NHK-DOT/delta_on_quadrotorUAV/docs/README.md

# 78arm Operational Documentation

This directory contains operational records maintained by the 78arm parent
repository. Documents here are not part of the nested upstream
`Uav_Delta_capture` Git repository.

## Available Documents

- [NX–STM32MP257 Wired LAN and ROS 2 Verification](NX_257_WIRED_LAN_AND_ROS2.md)
- [NX–STM32MP257 有线局域网与 ROS 2 通信验证](NX_257_WIRED_LAN_AND_ROS2.zh-CN.md)

The documents record verified device configuration and test results. They do
not grant flight authority or replace on-site safety checks.
