NHK-DOT/delta_on_quadrotorUAV/docs/README.zh-CN.md

# 78arm 运行文档

本目录保存由 78arm 父仓库维护的运行与验证记录，不属于嵌套的
`Uav_Delta_capture` 上游 Git 仓库。

## 文档列表

- [NX–STM32MP257 有线局域网与 ROS 2 通信验证](NX_257_WIRED_LAN_AND_ROS2.zh-CN.md)
- [NX–STM32MP257 Wired LAN and ROS 2 Verification](NX_257_WIRED_LAN_AND_ROS2.md)

文档记录已经验证的设备配置和测试结果，不构成飞行授权，也不能替代现场
安全检查。
