NHK-DOT/delta_on_quadrotorUAV/Uav_Delta_capture/docs/README.zh-CN.md

# 无人机集成文档

本文件是中文独立入口。报告保留“王迪论文报告”模板的排版、页面设置和表格结构，但内容改写为当前无人机抓取系统：STM32MP257 负责飞控任务主线，NX 负责视觉与机械臂，二者只通过受校验的观测与抓取状态接口协作。

文档不替代场地安全检查、飞控参数检查或人工飞行许可。
