NHK-DOT/delta_on_quadrotorUAV/THIRD_PARTY_NOTICES.md

# Third-Party Notices

## isaac879/Delta-Robot

Source: https://github.com/isaac879/Delta-Robot

License: MIT License

Upstream copyright:

```text
Copyright (c) 2019 isaac879 (Isaac Chasteau)
```

This repository's delta-arm mechanical concept and part of the early modeling
and control direction were based on the upstream Delta-Robot project. The model
files, hardware layout, control code, sensors, and deployment workflow in this
repository have been modified for this project's arm.

The overall 78arm repository is distributed under GNU GPL v3.0. The upstream MIT
notice below is preserved for MIT-origin material and attribution.

## MIT License Text

```text
MIT License

Copyright (c) 2019 isaac879 (Isaac Chasteau)

Permission is hereby granted, free of charge, to any person obtaining a copy
of this software and associated documentation files (the "Software"), to deal
in the Software without restriction, including without limitation the rights
to use, copy, modify, merge, publish, distribute, sublicense, and/or sell
copies of the Software, and to permit persons to whom the Software is
furnished to do so, subject to the following conditions:

The above copyright notice and this permission notice shall be included in all
copies or substantial portions of the Software.

THE SOFTWARE IS PROVIDED "AS IS", WITHOUT WARRANTY OF ANY KIND, EXPRESS OR
IMPLIED, INCLUDING BUT NOT LIMITED TO THE WARRANTIES OF MERCHANTABILITY,
FITNESS FOR A PARTICULAR PURPOSE AND NONINFRINGEMENT. IN NO EVENT SHALL THE
AUTHORS OR COPYRIGHT HOLDERS BE LIABLE FOR ANY CLAIM, DAMAGES OR OTHER
LIABILITY, WHETHER IN AN ACTION OF CONTRACT, TORT OR OTHERWISE, ARISING FROM,
OUT OF OR IN CONNECTION WITH THE SOFTWARE OR THE USE OR OTHER DEALINGS IN THE
SOFTWARE.
```
