NHK-DOT/delta_on_quadrotorUAV/Uav_Delta_capture/UPSTREAM_SOURCE.md

# Upstream Source / 上游来源

## English

This directory is an imported integration copy of the UAV ROS 2 project. It originates from `https://github.com/Nocoding0/Uav_Delta_capture.git` at commit `1c27e88051174780e2267d8d063ff80affeebd91` (`after the first competition`, fetched July 13, 2026).

It is intentionally maintained inside the 78arm repository so the NX vision-and-arm integration can evolve without pushing changes to the upstream repository. Do not add the upstream `.git` directory here. Upstream flight-control, UWB, and STM32MP257 code remains attributable to the source project.

## 中文

本目录是无人机 ROS 2 项目的导入集成副本，来源为 `https://github.com/Nocoding0/Uav_Delta_capture.git`，固定提交为 `1c27e88051174780e2267d8d063ff80affeebd91`（`after the first competition`，获取日期为 2026-07-13）。

本副本刻意维护在 78arm 仓库内，使 NX 的视觉与机械臂集成可以演进，同时不向上游仓库推送修改。此处不得放入上游 `.git` 目录。飞控、UWB 和 STM32MP257 代码仍应明确归属原项目。
