NHK-DOT/delta_on_quadrotorUAV/最新ALX-AOA-FIT跟随套件开发资料/示例代码/例程说明.txt

STM32F1-Usart    压缩包是STM32单片机串口获取基站数据的代码例程。
