NHK-DOT/delta_on_quadrotorUAV/最新ALX-AOA-FIT跟随套件开发资料/单基站&双基站&四基站/基站转接板安装孔位.pdf

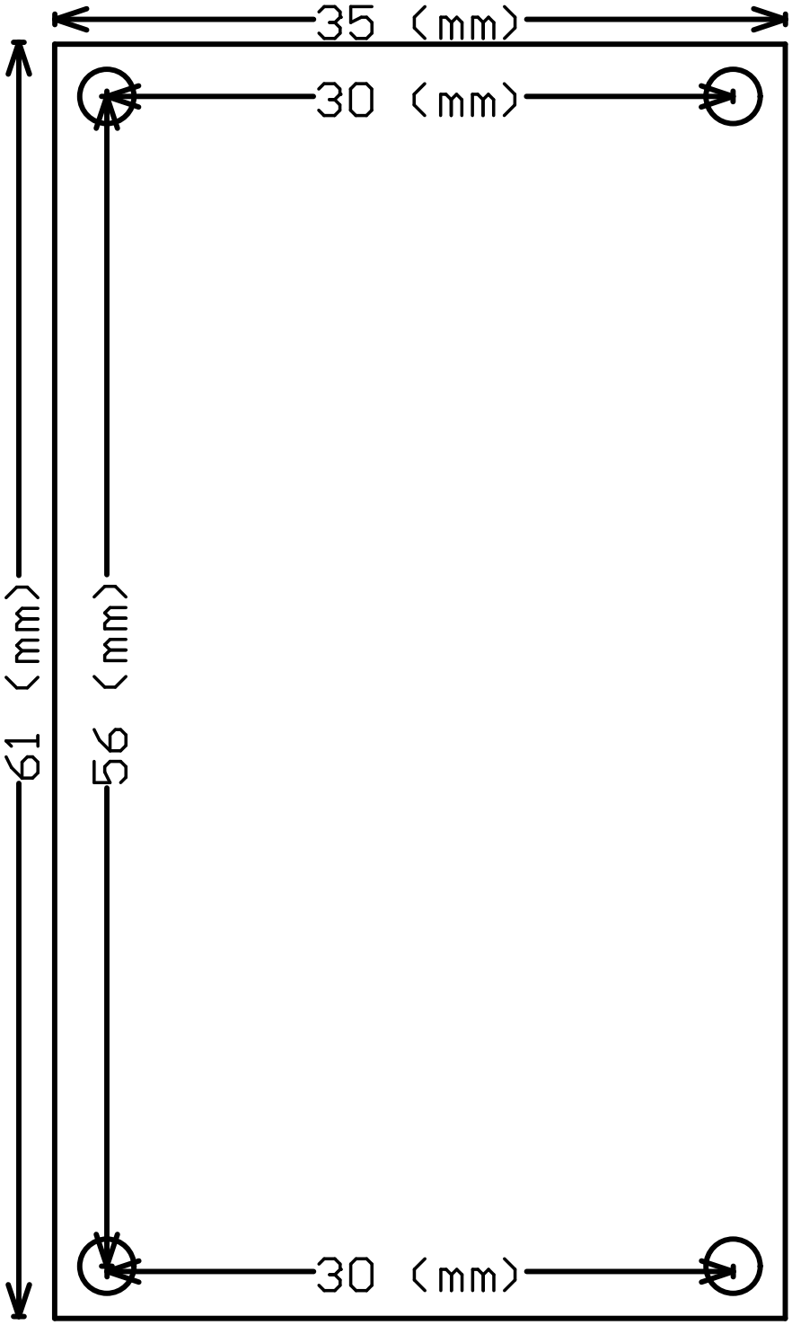
[picture p36: figure]
