NHK-DOT/delta_on_quadrotorUAV/Uav_Delta_capture/archive_legacy/20260413.md

# 2026-04-13 工作记录

## 今日目标
- 推进“模拟飞控 + 真实飞控基础链路”从骨架到可联调状态。
- 优先打通“桥接 -> failsafe -> 运动学”执行闭环。

## 今日主要改动

### 1) 运动学输入可切换（接入 failsafe 输出）
- 为 `delta_kinematics_node` 增加参数 `target_topic`。
- 支持将运动学输入从 `target_point` 切换为 `target_point_safe`。

涉及文件：
- src/delta_kinematics/include/delta_kinematics/delta_kinematics.hpp
- src/delta_kinematics/src/delta_kinematics_node.cpp
- src/delta_kinematics/config/delta_kinematics.yaml

### 2) FCU 链路健康监控增强
- 在 `fcu_link_monitor_node` 增加去抖参数：
  - `lost_threshold_count`
  - `ok_threshold_count`
- 避免短时抖动导致状态频繁误切换。

涉及文件：
- src/uav_bridge/src/fcu_link_monitor_node.cpp
- src/uav_bridge/config/fcu_health.yaml

### 3) failsafe 输出机制增强
- 在 `failsafe_manager_node` 增加：
  - `input_timeout_sec`（输入新鲜度判断）
  - `output_rate_hz`（周期输出）
- 实现“链路异常时持续输出安全点”。

涉及文件：
- src/uav_bridge/src/failsafe_manager_node.cpp
- src/uav_bridge/config/failsafe.yaml

### 4) 启动编排统一
- 重构统一启动：`uav_delta_system.launch.py`，支持：
  - `use_mock_fcu`
  - `start_mavros`
  - `start_fcu_guard`
  - `delta_target_topic`
- `uav_delta_with_mock_fcu.launch.py` 与 `uav_delta_with_fcu.launch.py` 改为复用统一系统启动。

涉及文件：
- src/uav_bridge/launch/uav_delta_system.launch.py
- src/uav_bridge/launch/uav_delta_with_mock_fcu.launch.py
- src/uav_bridge/launch/uav_delta_with_fcu.launch.py

### 5) 依赖与文档同步
- MAVROS 参数模板兼容性调整（`/**:` 作用域）。
- `package.xml` 增加运行依赖 `mavros`。
- README 更新路径与统一启动示例。

涉及文件：
- src/uav_bridge/config/mavros_bridge.yaml
- src/uav_bridge/package.xml
- uav_delta_capture/README.md

## 今日遇到的报错/异常

1. 终端会话中断
- 现象：执行串联验证命令时出现终端被关闭、命令退出 `130`。
- 原因：多段命令中含中断/超时流程，导致会话被提前终止。
- 处理：改为分步执行；出现残留进程时用 `pkill` 清理。

2. 话题采样时短暂告警
- 现象：`ros2 topic hz /mavros/local_position/pose` 提示 `topic does not appear to be published yet`。
- 原因：采样开始早于系统稳定拉起时刻。
- 处理：增加启动等待时间并通过 launch 日志确认节点已运行。

3. `KeyboardInterrupt`（Perception 节点）
- 现象：手动 `Ctrl-C` 结束联调时，Python 节点抛出中断栈。
- 结论：正常退出路径，不是功能性缺陷。

4. `get_changed_files` 提示非 git 仓库
- 现象：工具返回当前目录不是 git 仓库。
- 处理：改用直接文件核对与构建验证，不影响本次实现。

## 今日问题解决清单
- 解决了 failsafe 输出未进入运动学执行链的问题。
- 解决了健康状态抖动易误触发的问题（增加门限去抖）。
- 解决了启动文件重复维护的问题（统一系统启动入口）。
- 解决了 mock/真实 FCU 切换成本高的问题（参数化切换）。

## 今日达成成果
- 已形成可联调最小闭环：
  - Mock FCU -> `/mavros/local_position/pose`
  - `fcu_link_monitor_node` -> `fcu_link/status`
  - `failsafe_manager_node` -> `target_point_safe`
  - `delta_kinematics_node` 消费安全目标并输出 `joint_angles`
- 构建验证通过：
  - `colcon build --symlink-install --packages-select uav_bridge delta_kinematics`
- 启动参数检查通过：
  - 系统启动、mock 启动、FCU 启动均可展示参数列表。

## 下一步建议
1. 为 `flight_state_machine_node` 增加恢复保持窗口、故障锁存与更明确迁移条件。
2. 增加诊断输出（故障码、最近心跳时间、触发计数）。
3. 增加最小控制面骨架（arming/mode service client），先做接口不下发危险动作。
4. 固化 TF/坐标系约定并写入联调规范，避免后续返工。
