NHK-DOT/delta_on_quadrotorUAV/AprilTag_Vision/myAprilTag/image/tag36h11_id_08_80mm.png

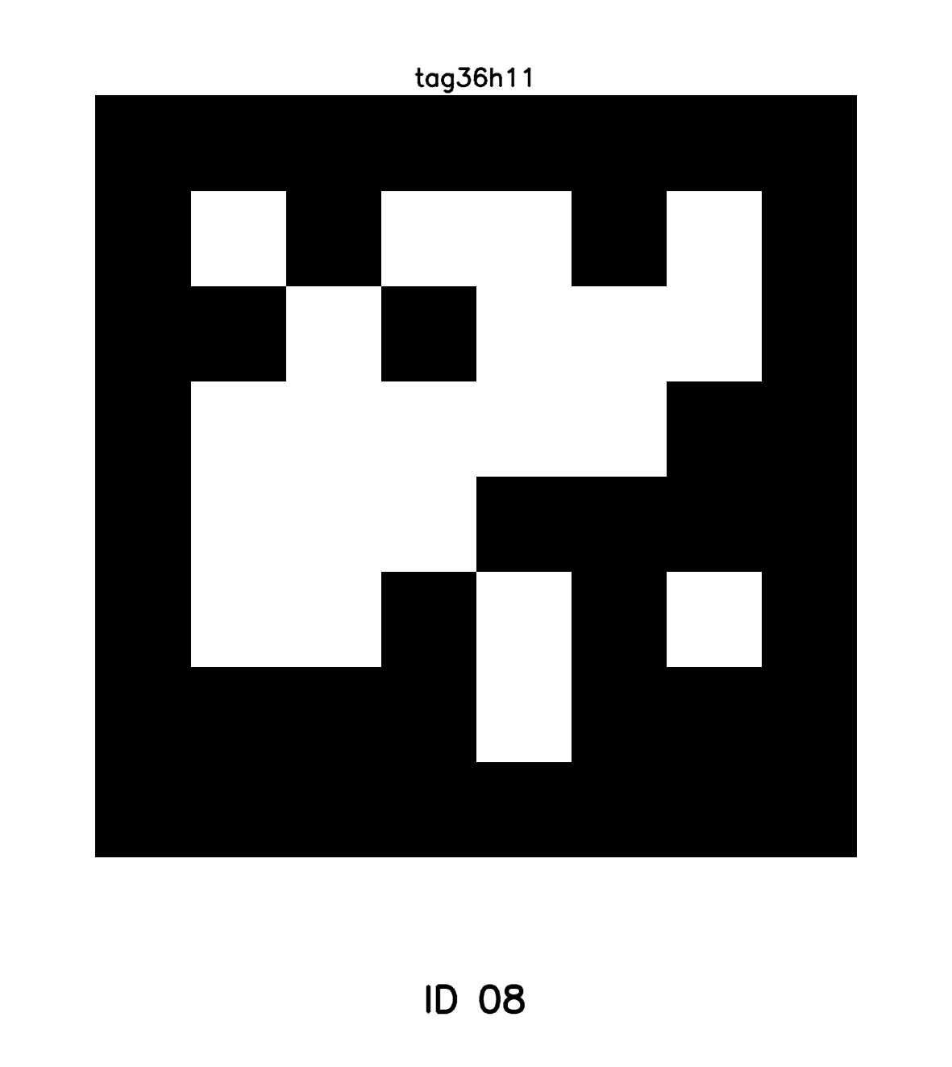
AprilTag_Vision/myAprilTag/image/tag36h11_id_08_80mm.png
