NHK-DOT/delta_on_quadrotorUAV/AprilTag_Vision/myAprilTag/image/tag36h11_sheet_page_02_80mm_A4.png

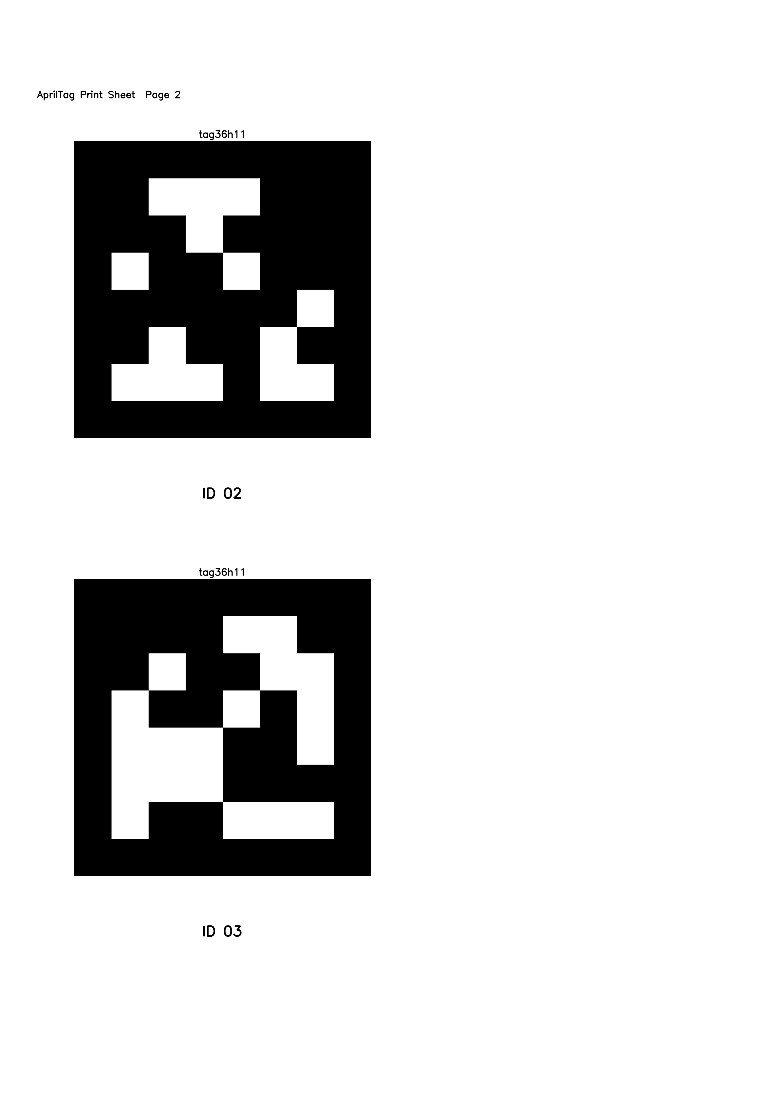
AprilTag_Vision/myAprilTag/image/tag36h11_sheet_page_02_80mm_A4.png
