NHK-DOT/delta_on_quadrotorUAV/Dual_Camera_HandEye/yolo_training/datasets/wrench_autolabel_20260626/images/train/wrench_static_1782480276551_00001.jpg

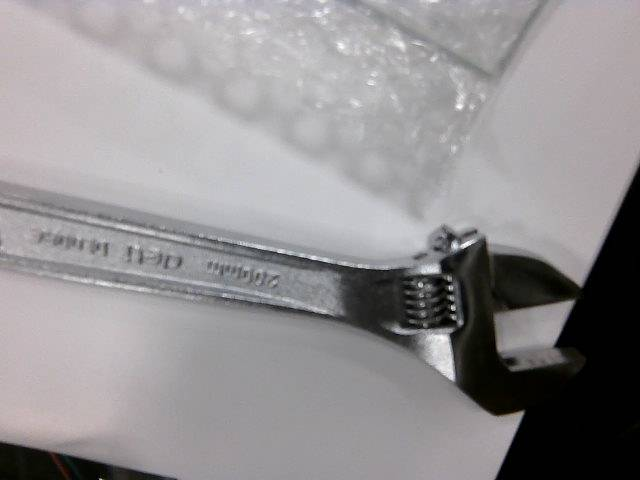
Dual_Camera_HandEye/yolo_training/datasets/wrench_autolabel_20260626/images/train/wrench_static_1782480276551_00001.jpg
