NHK-DOT/delta_on_quadrotorUAV/Dual_Camera_HandEye/yolo_training/datasets/wrench_autolabel_20260626_flight_aug/images/val/wrench_static_val_1782480300179_00001_flightaug_01.jpg

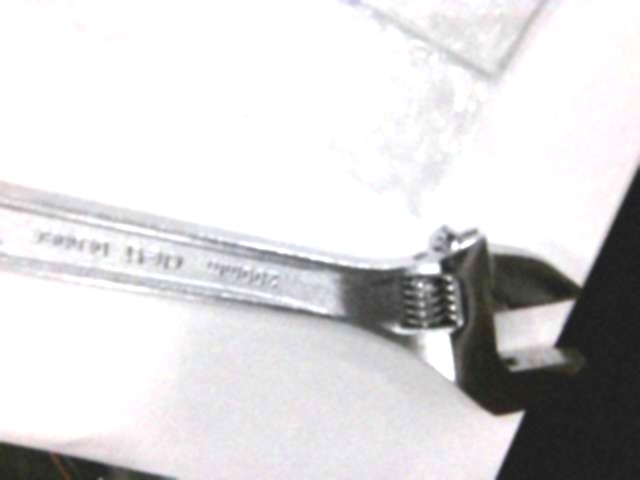
Dual_Camera_HandEye/yolo_training/datasets/wrench_autolabel_20260626_flight_aug/images/val/wrench_static_val_1782480300179_00001_flightaug_01.jpg
