NHK-DOT/delta_on_quadrotorUAV/Dual_Camera_HandEye/yolo_training/datasets/wrench_autolabel_20260626_qc_contact_sheet.jpg

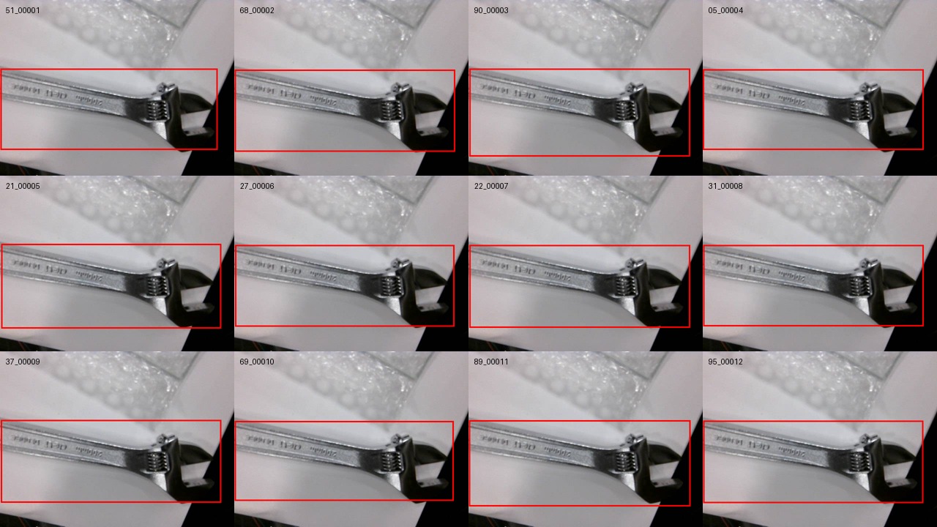
Dual_Camera_HandEye/yolo_training/datasets/wrench_autolabel_20260626_qc_contact_sheet.jpg
