NHK-DOT/delta_on_quadrotorUAV/Dual_Camera_HandEye/yolo_training/datasets/wrench_motion_autolabel_20260626_214357/images/train/motion_p00_f00_1782481438606.jpg

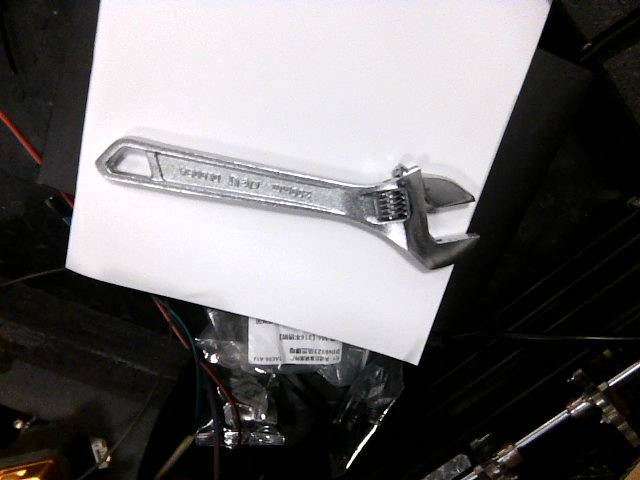
Dual_Camera_HandEye/yolo_training/datasets/wrench_motion_autolabel_20260626_214357/images/train/motion_p00_f00_1782481438606.jpg
