NHK-DOT/delta_on_quadrotorUAV/Dual_Camera_HandEye/yolo_training/datasets/wrench_motion_autolabel_20260626_214357/images/train/motion_p01_f01_1782481439942.jpg

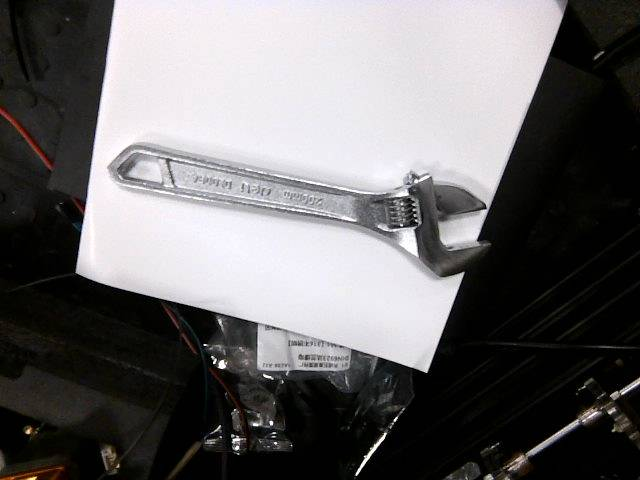
Dual_Camera_HandEye/yolo_training/datasets/wrench_motion_autolabel_20260626_214357/images/train/motion_p01_f01_1782481439942.jpg
