NHK-DOT/delta_on_quadrotorUAV/images/airframe/22-18 250mm碳纤维管机臂.jpg

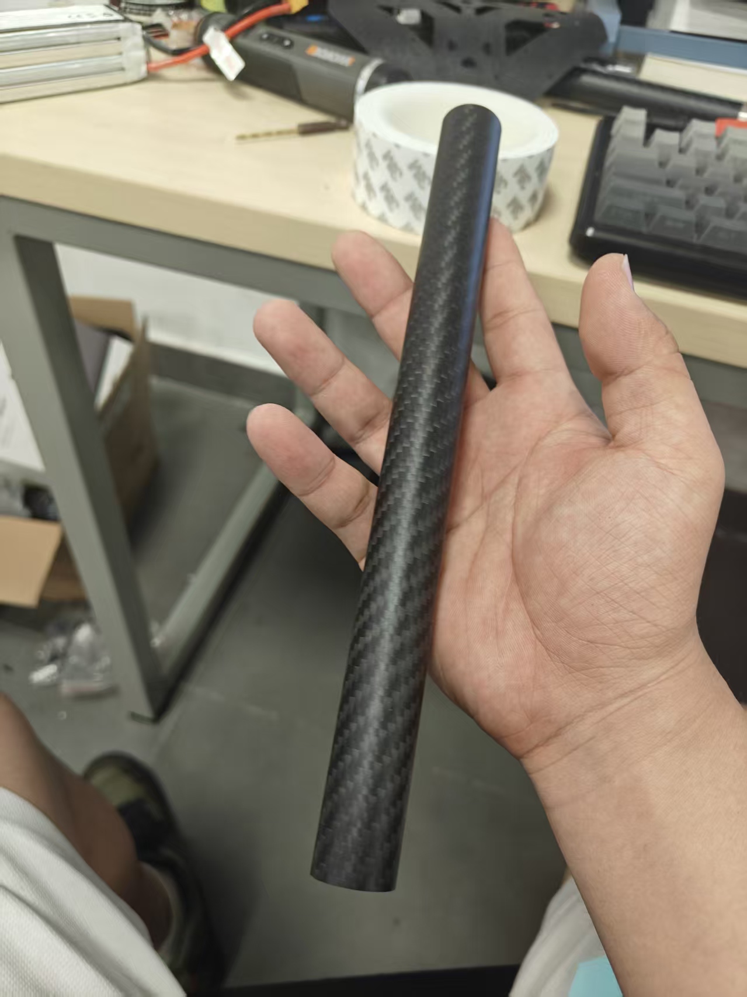
images/airframe/22-18 250mm碳纤维管机臂.jpg
