NHK-DOT/delta_on_quadrotorUAV/images/airframe/单根机臂一览.jpg

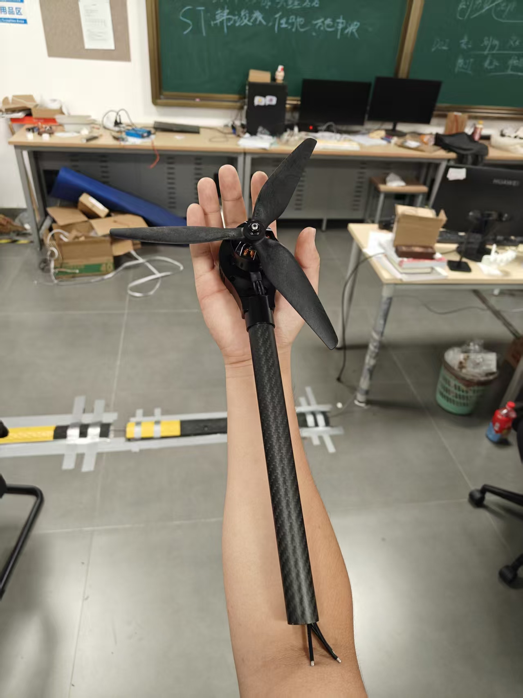
images/airframe/单根机臂一览.jpg
