NHK-DOT/delta_on_quadrotorUAV/images/airframe/大肌佬.jpg

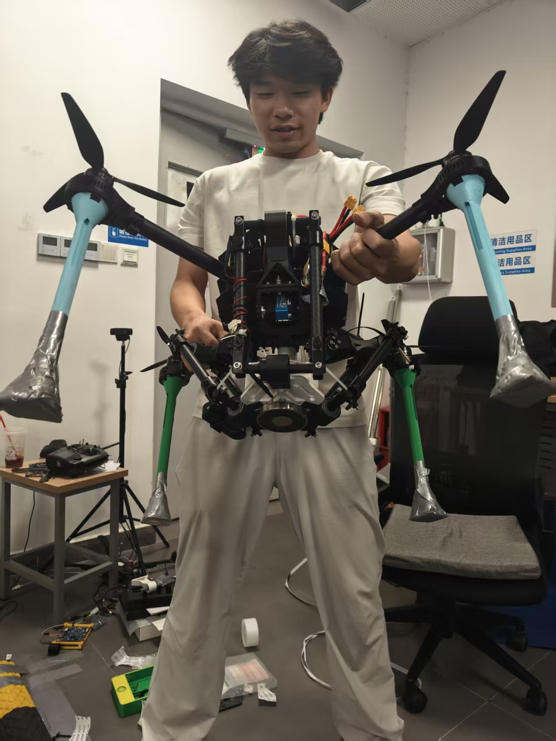
images/airframe/大肌佬.jpg
