NHK-DOT/delta_on_quadrotorUAV/images/airframe/定妆照.jpg

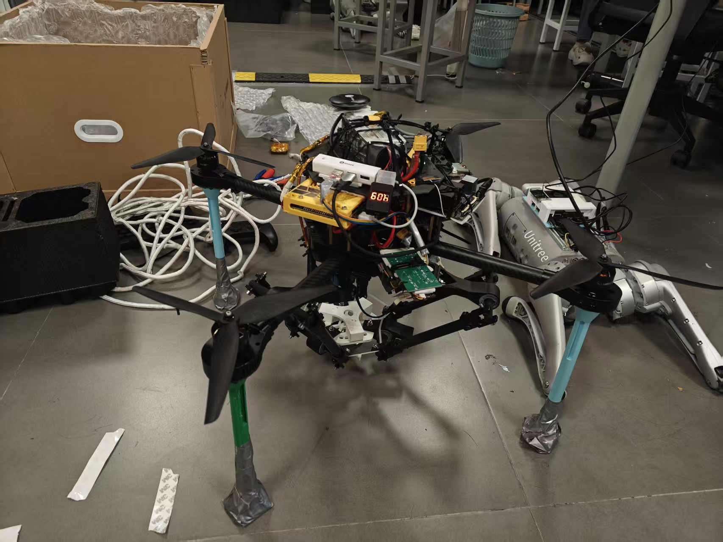
images/airframe/定妆照.jpg
