NHK-DOT/delta_on_quadrotorUAV/images/arm/3d对应一览.jpg

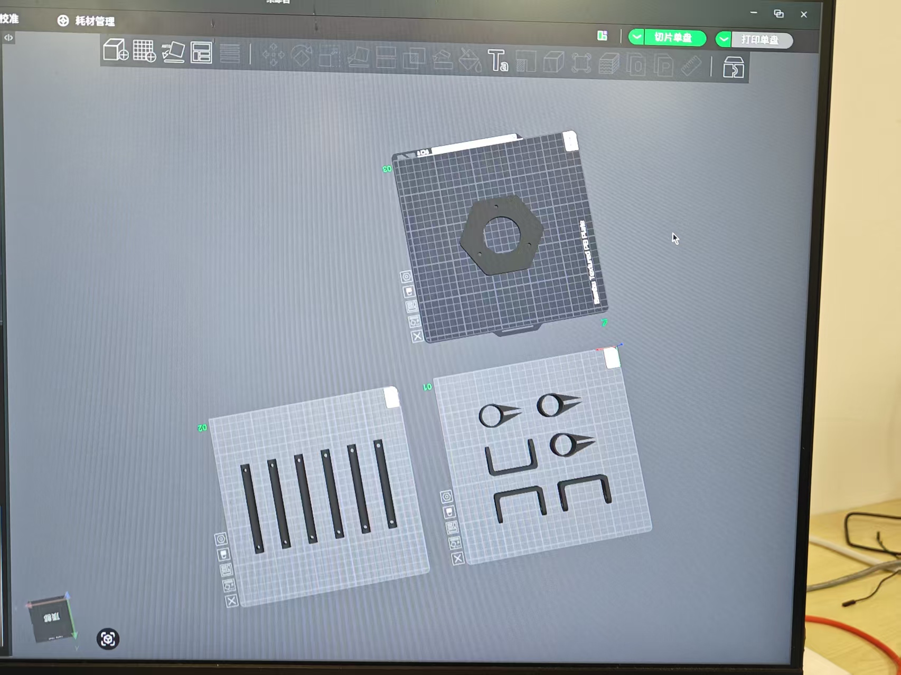
images/arm/3d对应一览.jpg
