NHK-DOT/delta_on_quadrotorUAV/images/arm/RGBD相机.jpg

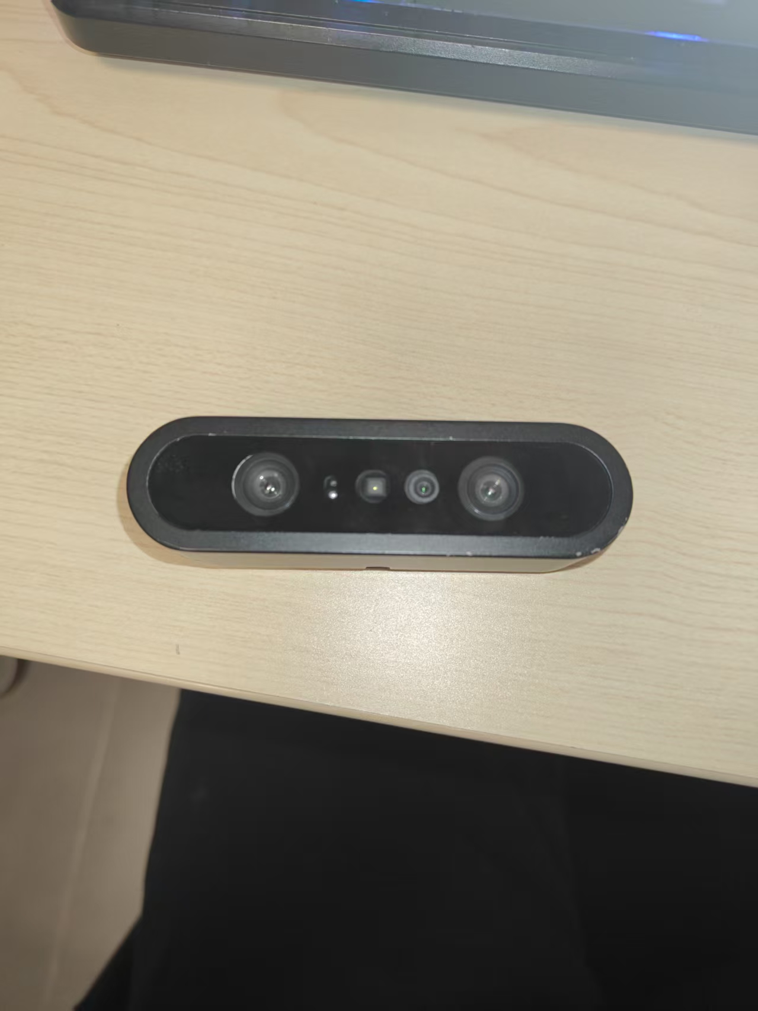
images/arm/RGBD相机.jpg
