NHK-DOT/delta_on_quadrotorUAV/images/arm/下小臂.jpg

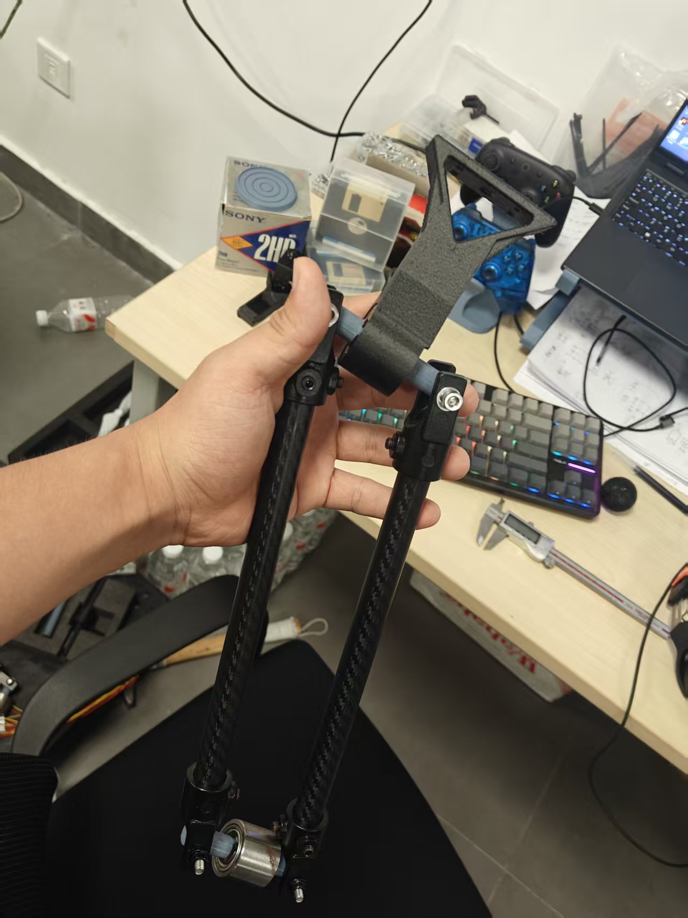
images/arm/下小臂.jpg
