NHK-DOT/delta_on_quadrotorUAV/images/arm/大（上）臂.jpg

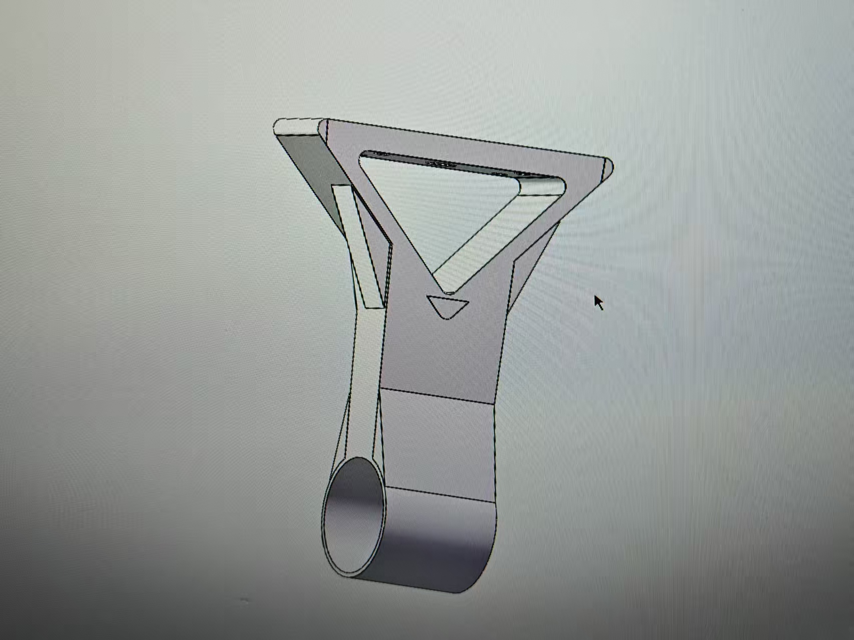
images/arm/大（上）臂.jpg
