NHK-DOT/delta_on_quadrotorUAV/images/arm/快拆末端中心板.png

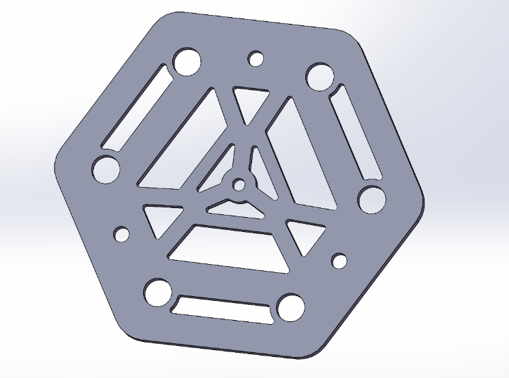
images/arm/快拆末端中心板.png
