NHK-DOT/delta_on_quadrotorUAV/images/arm/末端一览.jpg

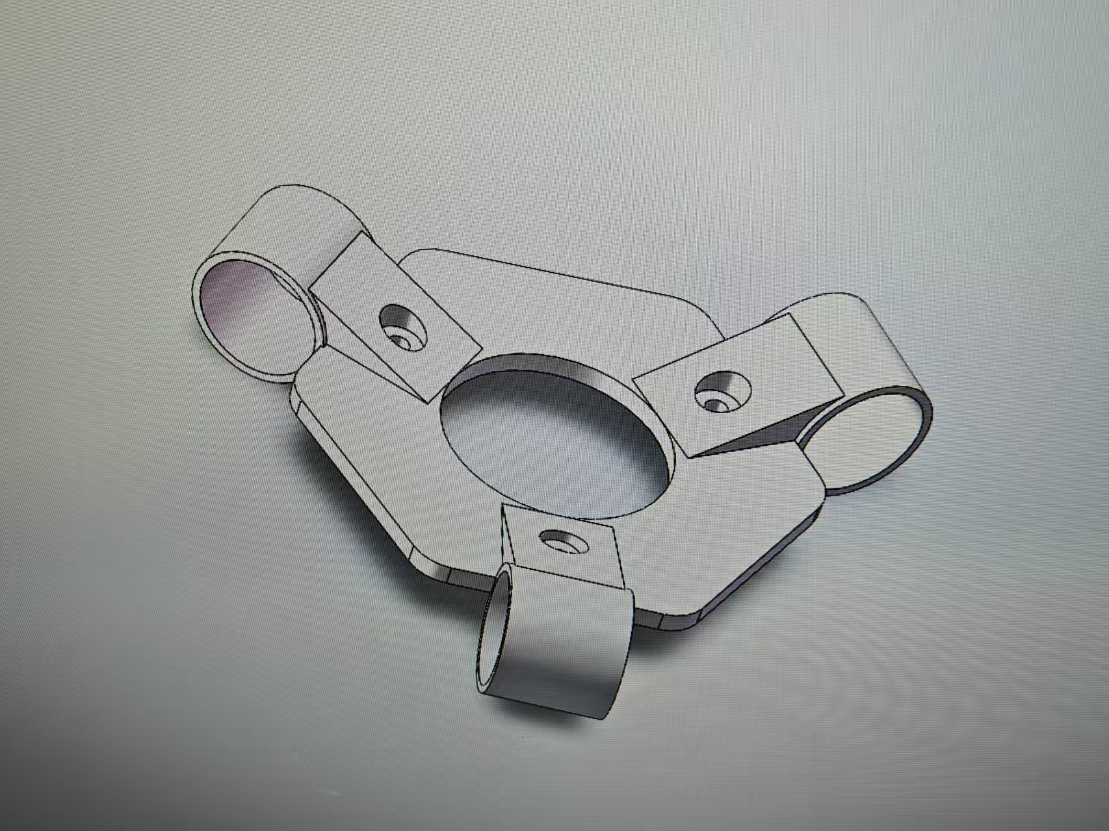
images/arm/末端一览.jpg
