NHK-DOT/delta_on_quadrotorUAV/images/arm/机械臂底盘.png

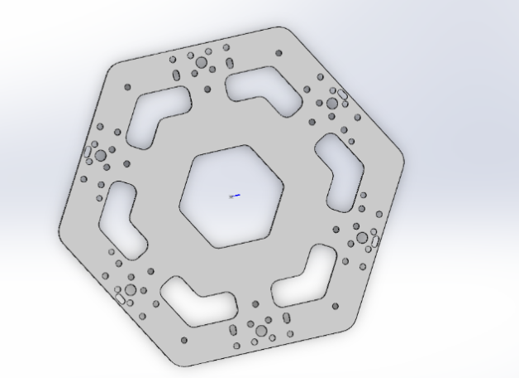
images/arm/机械臂底盘.png
