NHK-DOT/delta_on_quadrotorUAV/images/arm/轴承套筒6001.png

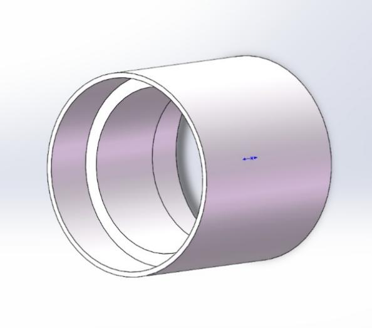
images/arm/轴承套筒6001.png
