NHK-DOT/delta_on_quadrotorUAV/images/electronics/773f6542a918e4f045dfaee116f9853e.png

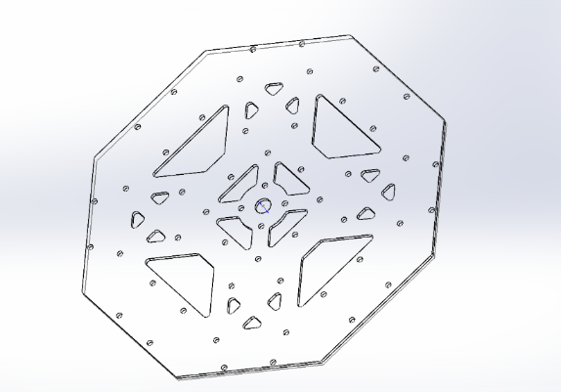
images/electronics/773f6542a918e4f045dfaee116f9853e.png
