NHK-DOT/delta_on_quadrotorUAV/images/electronics/分电成品.png

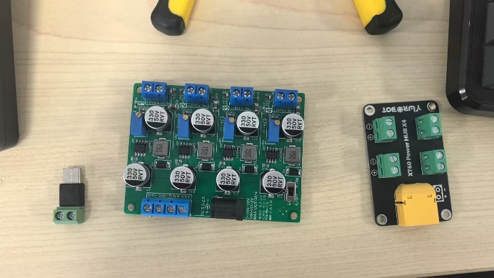
images/electronics/分电成品.png
