NHK-DOT/delta_on_quadrotorUAV/images/electronics/手绘分电.png

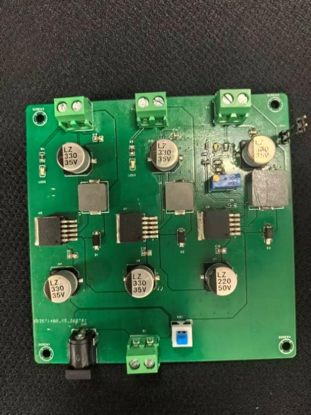
images/electronics/手绘分电.png
