NHK-DOT/delta_on_quadrotorUAV/images/electronics/电调好盈科技XRotor_65A_4in1_6S_Lite_BLS_RTF.png

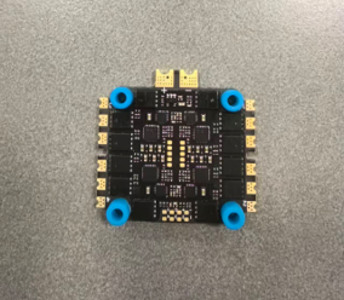
images/electronics/电调好盈科技XRotor_65A_4in1_6S_Lite_BLS_RTF.png
