NHK-DOT/delta_on_quadrotorUAV/tool_vision_web/jetson_raw_probe.jpg

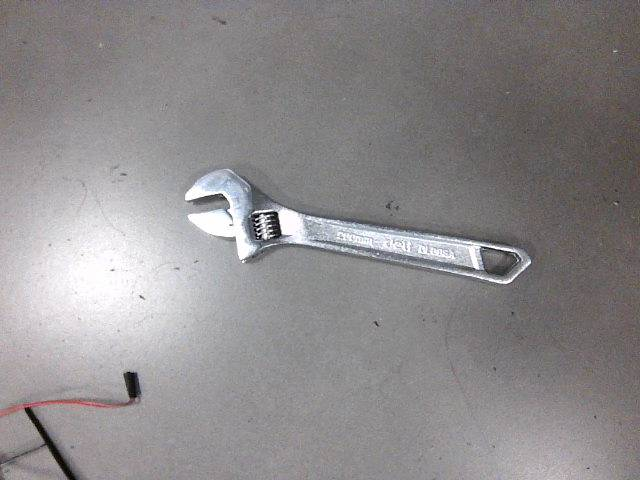
tool_vision_web/jetson_raw_probe.jpg
