NHK-DOT/delta_on_quadrotorUAV/(list of files, cad)

Other CAD files:
drawings/desktop_cad_import_20260714/【RM2024-空中机器人结构开源】-深圳大学-RobotPilots战队/三维模型/云台/相机/装配体-视觉相机镜头.SLDASM
drawings/desktop_cad_import_20260714/【RM2024-空中机器人结构开源】-深圳大学-RobotPilots战队/三维模型/机架上层/飞控安装板/装配体-飞控安装板.SLDASM
drawings/desktop_cad_import_20260714/【RM2024-空中机器人结构开源】-深圳大学-RobotPilots战队/三维模型/机臂动力套装/装配体-机臂动力套装-圆管-反.SLDASM
drawings/desktop_cad_import_20260714/【RM2024-空中机器人结构开源】-深圳大学-RobotPilots战队/三维模型/机架上层/电池架/M600配件/官方元件-M600电池架.SLDASM
drawings/desktop_cad_import_20260714/【RM2024-空中机器人结构开源】-深圳大学-RobotPilots战队/三维模型/机架上层/电池架/装配体-电池架及电池.SLDASM
drawings/desktop_cad_import_20260714/【RM2024-空中机器人结构开源】-深圳大学-RobotPilots战队/三维模型/机架上层/飞控安装板/标准件-DJI - A3 - LED Module.SLDASM
drawings/desktop_cad_import_20260714/【RM2024-空中机器人结构开源】-深圳大学-RobotPilots战队/三维模型/机臂动力套装/螺旋桨/装配体-2892反桨.SLDASM
drawings/desktop_cad_import_20260714/【RM2024-空中机器人结构开源】-深圳大学-RobotPilots战队/三维模型/机臂动力套装/装配体-机臂动力套装-圆管.SLDASM
drawings/desktop_cad_import_20260714/【RM2024-空中机器人结构开源】-深圳大学-RobotPilots战队/三维模型/云台/NUC12/装配体-NUC12保护装配.SLDASM
drawings/desktop_cad_import_20260714/【RM2024-空中机器人结构开源】-深圳大学-RobotPilots战队/三维模型/云台/设备/标准件-主控板装配.SLDASM
drawings/desktop_cad_import_20260714/【RM2024-空中机器人结构开源】-深圳大学-RobotPilots战队/三维模型/机架上层/飞猫连接架/装配体-飞猫连接架.SLDASM
drawings/desktop_cad_import_20260714/【RM2024-空中机器人结构开源】-深圳大学-RobotPilots战队/三维模型/机臂动力套装/螺旋桨/装配体-2892正桨.SLDASM
drawings/desktop_cad_import_20260714/【RM2024-空中机器人结构开源】-深圳大学-RobotPilots战队/三维模型/云台/装配体-云台设备仓.SLDASM
drawings/desktop_cad_import_20260714/【RM2024-空中机器人结构开源】-深圳大学-RobotPilots战队/三维模型/机架上层/拨盘总装（2_10）/装配体-拨盘.SLDASM
drawings/desktop_cad_import_20260714/【RM2024-空中机器人结构开源】-深圳大学-RobotPilots战队/三维模型/机架上层/装配体-机架上层.SLDASM
drawings/desktop_cad_import_20260714/【RM2024-空中机器人结构开源】-深圳大学-RobotPilots战队/三维模型/机架上层/起落架/装配-起落架.SLDASM
drawings/desktop_cad_import_20260714/【RM2024-空中机器人结构开源】-深圳大学-RobotPilots战队/三维模型/云台/摩擦轮电机/标准件-朗宇2212-KV980.SLDASM
drawings/desktop_cad_import_20260714/【RM2024-空中机器人结构开源】-深圳大学-RobotPilots战队/三维模型/机臂动力套装/桨保/装配-桨保.SLDASM
drawings/desktop_cad_import_20260714/【RM2024-空中机器人结构开源】-深圳大学-RobotPilots战队/三维模型/机架上层/标准件-DJI - A3 - GPS-Compass PRO.SLDASM
drawings/desktop_cad_import_20260714/【RM2024-空中机器人结构开源】-深圳大学-RobotPilots战队/三维模型/机架上层/UWB支架/UWB碳板支架装配.SLDASM
drawings/desktop_cad_import_20260714/【RM2024-空中机器人结构开源】-深圳大学-RobotPilots战队/三维模型/云台/装配体-云台Pitch装配.SLDASM
part_model_rev/1.SLDASM
part_model_rev/对孔.SLDASM
part_model_rev/配合.SLDASM
drawings/desktop_cad_import_20260714/【RM2024-空中机器人结构开源】-深圳大学-RobotPilots战队/三维模型/云台/装配体-云台.SLDASM
drawings/desktop_cad_import_20260714/【RM2024-空中机器人结构开源】-深圳大学-RobotPilots战队/三维模型/云台/NUC12/NUC12简化.SLDPRT
drawings/desktop_cad_import_20260714/【RM2024-空中机器人结构开源】-深圳大学-RobotPilots战队/三维模型/云台/摩擦轮电机/eje.SLDPRT
drawings/desktop_cad_import_20260714/【RM2024-空中机器人结构开源】-深圳大学-RobotPilots战队/三维模型/云台/板材-7010电机侧板 -国赛.SLDPRT
drawings/desktop_cad_import_20260714/【RM2024-空中机器人结构开源】-深圳大学-RobotPilots战队/三维模型/云台/设备/标准件-XT30ULW-F.SLDPRT
drawings/desktop_cad_import_20260714/【RM2024-空中机器人结构开源】-深圳大学-RobotPilots战队/三维模型/小推车/打印件-小推车90度转接.SLDPRT
drawings/desktop_cad_import_20260714/【RM2024-空中机器人结构开源】-深圳大学-RobotPilots战队/三维模型/机架上层/UWB支架/标准件-M3x16铝柱.SLDPRT
drawings/desktop_cad_import_20260714/【RM2024-空中机器人结构开源】-深圳大学-RobotPilots战队/三维模型/机架上层/拨盘总装（2_10）/打印件-拨盘外壁v1.3.SLDPRT
drawings/desktop_cad_import_20260714/【RM2024-空中机器人结构开源】-深圳大学-RobotPilots战队/三维模型/机架上层/标准件-gps安装座.SLDPRT
drawings/desktop_cad_import_20260714/【RM2024-空中机器人结构开源】-深圳大学-RobotPilots战队/三维模型/机架上层/电池架/M600配件/官方元件-电池架铜片.SLDPRT
drawings/desktop_cad_import_20260714/【RM2024-空中机器人结构开源】-深圳大学-RobotPilots战队/三维模型/机架上层/电池架/打印件-电池架固定座.SLDPRT
drawings/desktop_cad_import_20260714/【RM2024-空中机器人结构开源】-深圳大学-RobotPilots战队/三维模型/机架上层/起落架/板材-起落架加强板.SLDPRT
drawings/desktop_cad_import_20260714/【RM2024-空中机器人结构开源】-深圳大学-RobotPilots战队/三维模型/机架上层/飞猫连接架/标准件-16mm管夹.SLDPRT
drawings/desktop_cad_import_20260714/【RM2024-空中机器人结构开源】-深圳大学-RobotPilots战队/三维模型/机臂动力套装/桨保/打印件-桨保机臂中段连接.SLDPRT
drawings/desktop_cad_import_20260714/【RM2024-空中机器人结构开源】-深圳大学-RobotPilots战队/三维模型/机臂动力套装/航行灯/打印件-顶部灯条.SLDPRT
drawings/desktop_cad_import_20260714/【RM2024-空中机器人结构开源】-深圳大学-RobotPilots战队/三维模型/机臂动力套装/螺旋桨/标准件-2892螺旋桨-反.SLDPRT
drawings/desktop_cad_import_20260714/【RM2024-空中机器人结构开源】-深圳大学-RobotPilots战队/三维模型/装配体-RoboMaster2024深圳大学空中机器人.STEP
drawings/desktop_cad_import_20260714/肱二头肌.STL
part_model_rev/保存实体1[2].SLDPRT
drawings/desktop_cad_import_20260714/78.STL
drawings/desktop_cad_import_20260714/【RM2024-空中机器人结构开源】-深圳大学-RobotPilots战队/三维模型/云台/NUC12/NUC12WSB保护.SLDPRT
drawings/desktop_cad_import_20260714/【RM2024-空中机器人结构开源】-深圳大学-RobotPilots战队/三维模型/云台/摩擦轮电机/angular contact ball bearing_68_iso.sldprt
drawings/desktop_cad_import_20260714/【RM2024-空中机器人结构开源】-深圳大学-RobotPilots战队/三维模型/云台/板材-云台pitch载板.SLDPRT
drawings/desktop_cad_import_20260714/【RM2024-空中机器人结构开源】-深圳大学-RobotPilots战队/三维模型/云台/相机/标准件-镜头.SLDPRT
drawings/desktop_cad_import_20260714/【RM2024-空中机器人结构开源】-深圳大学-RobotPilots战队/三维模型/云台/设备/标准件-DR16.SLDPRT
drawings/desktop_cad_import_20260714/【RM2024-空中机器人结构开源】-深圳大学-RobotPilots战队/三维模型/小推车/打印件-小推车90度方管.SLDPRT
drawings/desktop_cad_import_20260714/【RM2024-空中机器人结构开源】-深圳大学-RobotPilots战队/三维模型/机架上层/UWB支架/UWB连接.SLDPRT
drawings/desktop_cad_import_20260714/【RM2024-空中机器人结构开源】-深圳大学-RobotPilots战队/三维模型/机架上层/拨盘总装（2_10）/打印件-拨盘90度弹链.SLDPRT
drawings/desktop_cad_import_20260714/【RM2024-空中机器人结构开源】-深圳大学-RobotPilots战队/三维模型/机架上层/板材-上层下板.SLDPRT
drawings/desktop_cad_import_20260714/【RM2024-空中机器人结构开源】-深圳大学-RobotPilots战队/三维模型/机架上层/起落架/标准件-Foot_Pad.SLDPRT
drawings/desktop_cad_import_20260714/【RM2024-空中机器人结构开源】-深圳大学-RobotPilots战队/三维模型/机架上层/飞猫连接架/板材-吊杆连接板.SLDPRT
drawings/desktop_cad_import_20260714/【RM2024-空中机器人结构开源】-深圳大学-RobotPilots战队/三维模型/机臂动力套装/桨保/标准件-M3x20铝柱.SLDPRT
part_model_rev/韩竣成 (1).3mf
drawings/desktop_cad_import_20260714/ajydgsaiuu.3mf
drawings/desktop_cad_import_20260714/【RM2024-空中机器人结构开源】-深圳大学-RobotPilots战队/三维模型/云台/NUC12/NUC12保护顶盖.SLDPRT
drawings/desktop_cad_import_20260714/【RM2024-空中机器人结构开源】-深圳大学-RobotPilots战队/三维模型/云台/摩擦轮电机/Base motor.SLDPRT
drawings/desktop_cad_import_20260714/【RM2024-空中机器人结构开源】-深圳大学-RobotPilots战队/三维模型/云台/标准件-图传M2x20铝柱.SLDPRT
drawings/desktop_cad_import_20260714/【RM2024-空中机器人结构开源】-深圳大学-RobotPilots战队/三维模型/云台/相机/标准件-HKVision.SLDPRT
drawings/desktop_cad_import_20260714/【RM2024-空中机器人结构开源】-深圳大学-RobotPilots战队/三维模型/云台/设备/标准件-XL4015降压模块.SLDPRT
drawings/desktop_cad_import_20260714/【RM2024-空中机器人结构开源】-深圳大学-RobotPilots战队/三维模型/机架上层/UWB支架/UWB顶板.SLDPRT
drawings/desktop_cad_import_20260714/【RM2024-空中机器人结构开源】-深圳大学-RobotPilots战队/三维模型/机架上层/板材-Guidance安装板.SLDPRT
drawings/desktop_cad_import_20260714/【RM2024-空中机器人结构开源】-深圳大学-RobotPilots战队/三维模型/机架上层/电池架/标准件-TB48S.SLDPRT
drawings/desktop_cad_import_20260714/【RM2024-空中机器人结构开源】-深圳大学-RobotPilots战队/三维模型/机架上层/起落架/加工件-起落架碳管下-600mm.SLDPRT
drawings/desktop_cad_import_20260714/【RM2024-空中机器人结构开源】-深圳大学-RobotPilots战队/三维模型/机架上层/飞控安装板/标准件-4孔交件.SLDPRT
drawings/desktop_cad_import_20260714/【RM2024-空中机器人结构开源】-深圳大学-RobotPilots战队/三维模型/机架上层/飞猫连接架/加工件-飞猫碳管.SLDPRT
drawings/desktop_cad_import_20260714/【RM2024-空中机器人结构开源】-深圳大学-RobotPilots战队/三维模型/机臂动力套装/标准件-铝合金平垫.SLDPRT
drawings/desktop_cad_import_20260714/【RM2024-空中机器人结构开源】-深圳大学-RobotPilots战队/三维模型/机臂动力套装/桨保/板材-桨保上边条-内边缘.SLDPRT
drawings/desktop_cad_import_20260714/【RM2024-空中机器人结构开源】-深圳大学-RobotPilots战队/三维模型/机臂动力套装/螺旋桨/标准件-2892螺旋桨-正.SLDPRT
part_model_rev/六边底盘改.SLDPRT
drawings/desktop_cad_import_20260714/【RM2024-空中机器人结构开源】-深圳大学-RobotPilots战队/三维模型/云台/摩擦轮电机/tuerca helice.SLDPRT
drawings/desktop_cad_import_20260714/【RM2024-空中机器人结构开源】-深圳大学-RobotPilots战队/三维模型/云台/标准件-M3x18铝柱.SLDPRT
drawings/desktop_cad_import_20260714/【RM2024-空中机器人结构开源】-深圳大学-RobotPilots战队/三维模型/机架上层/UWB支架/UWB-MID360固定板.SLDPRT
drawings/desktop_cad_import_20260714/【RM2024-空中机器人结构开源】-深圳大学-RobotPilots战队/三维模型/机架上层/打印件-LED安装座.SLDPRT
drawings/desktop_cad_import_20260714/【RM2024-空中机器人结构开源】-深圳大学-RobotPilots战队/三维模型/机架上层/拨盘总装（2_10）/板材-拨盘底板v1.0.SLDPRT
drawings/desktop_cad_import_20260714/【RM2024-空中机器人结构开源】-深圳大学-RobotPilots战队/三维模型/机架上层/电池架/打印件-电池架固定座-电线侧.SLDPRT
drawings/desktop_cad_import_20260714/【RM2024-空中机器人结构开源】-深圳大学-RobotPilots战队/三维模型/机架上层/起落架/标准件-起落架上管夹.SLDPRT
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
