NHK-DOT/delta_on_quadrotorUAV/Delta_Gcode_Servo/real_machine_test/calibration_snapshots/20260708_120837_manual_workspace_raw_stream.csv

sample_index | timestamp_local | elapsed_sec | success | raw1 | raw2 | raw3 | error | tx_hex | command_byte
1 | 2026-07-08T12:08:38 | 1.026 | True | 172 | -194 | 807 |  | 55 55 06 15 03 01 02 03 | 0x15
2 | 2026-07-08T12:08:41 | 4.001 | True | 172 | -194 | 808 |  | 55 55 06 15 03 01 02 03 | 0x15
3 | 2026-07-08T12:08:45 | 8.0 | True | 133 | -185 | 787 |  | 55 55 06 15 03 01 02 03 | 0x15
4 | 2026-07-08T12:08:49 | 12.001 | True | 42 | 1128 | 684 |  | 55 55 06 15 03 01 02 03 | 0x15
5 | 2026-07-08T12:08:53 | 16.0 | True | 159 | 1193 | 748 |  | 55 55 06 15 03 01 02 03 | 0x15
6 | 2026-07-08T12:08:57 | 20.0 | True | 527 | 75 | 981 |  | 55 55 06 15 03 01 02 03 | 0x15
7 | 2026-07-08T12:09:01 | 24.0 | True | 173 | 75 | 981 |  | 55 55 06 15 03 01 02 03 | 0x15
8 | 2026-07-08T12:09:05 | 28.001 | True | 318 | -2 | 768 |  | 55 55 06 15 03 01 02 03 | 0x15
9 | 2026-07-08T12:09:09 | 32.0 | True | 371 | 1193 | 716 |  | 55 55 06 15 03 01 02 03 | 0x15
10 | 2026-07-08T12:09:13 | 36.001 | True | 45 | 1081 | 838 |  | 55 55 06 15 03 01 02 03 | 0x15
11 | 2026-07-08T12:09:17 | 40.0 | True | 10 | 1078 | 623 |  | 55 55 06 15 03 01 02 03 | 0x15
12 | 2026-07-08T12:09:21 | 44.0 | True | 167 | 1079 | 628 |  | 55 55 06 15 03 01 02 03 | 0x15
13 | 2026-07-08T12:09:25 | 48.0 | True | -19 | 1078 | 625 |  | 55 55 06 15 03 01 02 03 | 0x15
14 | 2026-07-08T12:09:29 | 52.0 | True | 2 | 1080 | 750 |  | 55 55 06 15 03 01 02 03 | 0x15
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
43 | 2026-07-08T12:11:25 | 168.0 | True | 39 | 1125 | 681 |  | 55 55 06 15 03 01 02 03 | 0x15
44 | 2026-07-08T12:11:29 | 172.0 | True | 38 | 1125 | 682 |  | 55 55 06 15 03 01 02 03 | 0x15
45 | 2026-07-08T12:11:33 | 176.0 | True | 38 | 1125 | 681 |  | 55 55 06 15 03 01 02 03 | 0x15
