NHK-DOT/delta_on_quadrotorUAV/Dual_Camera_HandEye/yolo_training/trained_models/wrench_current_manual_affine_gpu_e15/BoxPR_curve.png

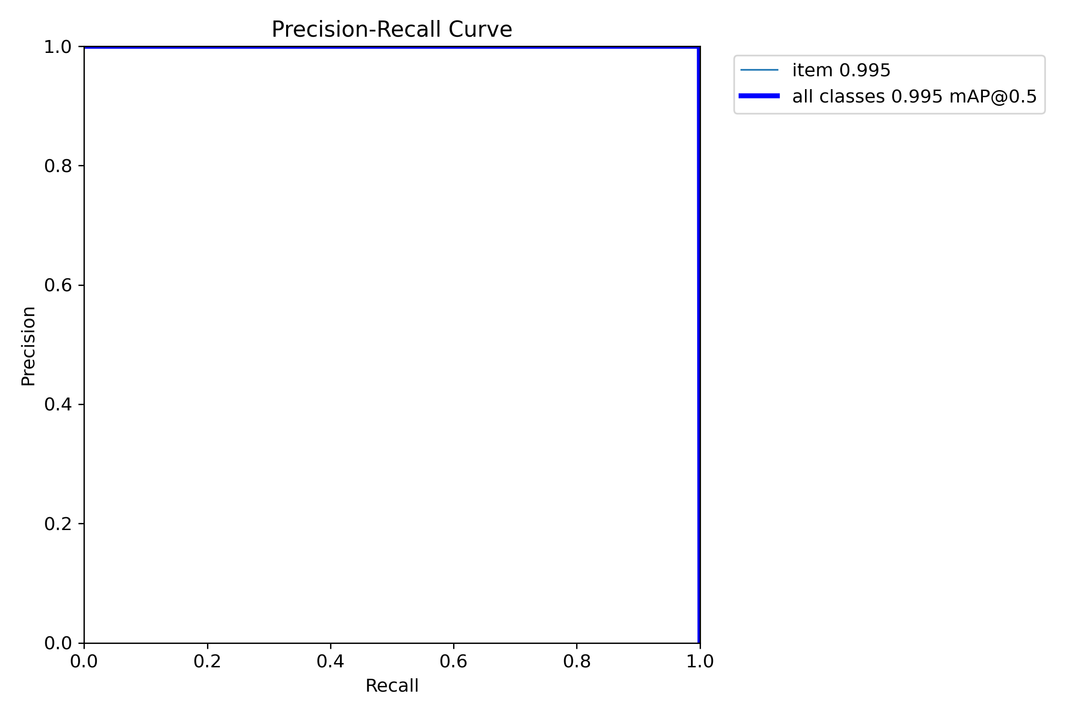
Dual_Camera_HandEye/yolo_training/trained_models/wrench_current_manual_affine_gpu_e15/BoxPR_curve.png
