NHK-DOT/delta_on_quadrotorUAV/Dual_Camera_HandEye/yolo_training/trained_models/wrench_current_manual_affine_gpu_e15/val_batch0_pred.jpg

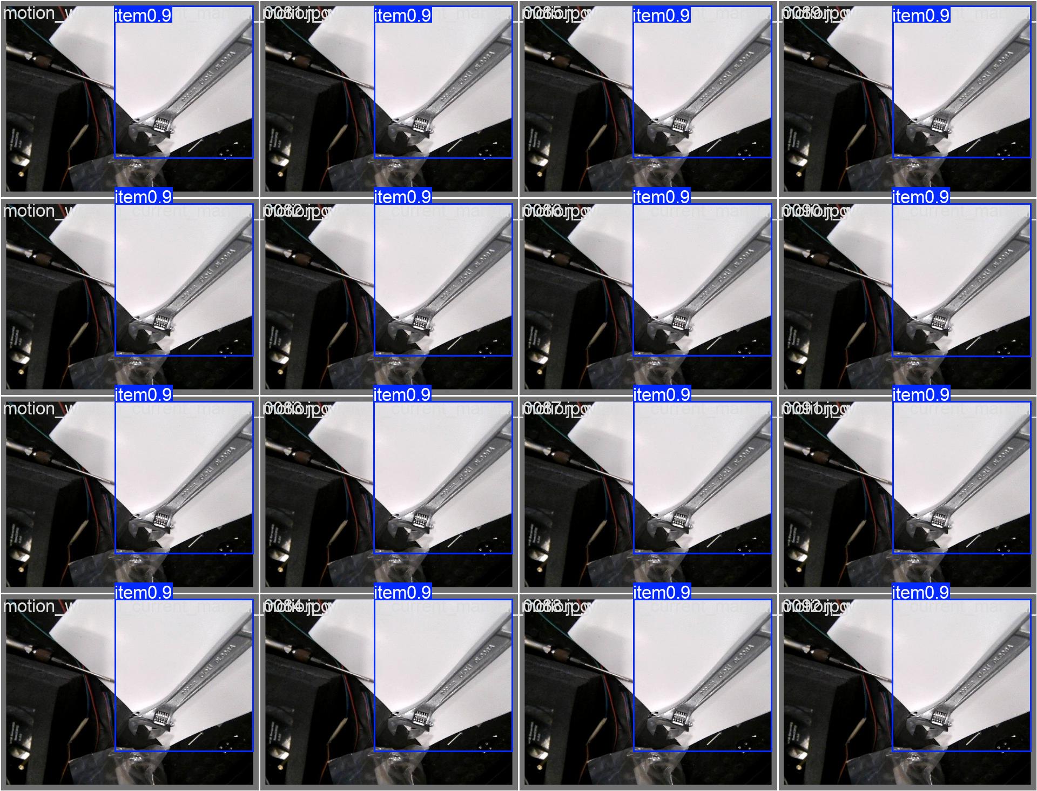
Dual_Camera_HandEye/yolo_training/trained_models/wrench_current_manual_affine_gpu_e15/val_batch0_pred.jpg
