NHK-DOT/delta_on_quadrotorUAV/Delta_Gcode_Servo/real_machine_test/jetson_py36/GPU_APRILTAG_PIPELINE_RULES.md

# GPU AprilTag Pipeline Rules

## 2026-06-24 Incident

An incorrect change replaced the Jetson 3K fisheye AprilTag runtime path with a
Python/OpenCV CPU detector because the CPU detector recognized the tag after
histogram equalization under the current dark lighting. That was the wrong
engineering decision for this project.

The workspace sampler depends on the high-frame-rate Jetson GPU AprilTag path.
Improving one still-image recognition result is not a valid reason to make the
default runtime fall back to a slower CPU detector.

The CPU fallback commit was reverted. The default sampler launch must remain:

```text
/home/nvidia/Desktop/yolo_fisheye_calibration_jetson/nv_gpu_apriltags_bench/run_fullfov_1280x960_gui.sh
```

## Non-Negotiable Rule

Do not replace the default AprilTag runtime with a CPU detector to solve a
lighting or thresholding problem.

If raw grayscale GPU detection fails in the current lighting, fix the image
before GPU detection while preserving the GPU `nvAprilTags` runtime path.

## Correct Direction

The correct fix is to insert a lightweight image-processing stage between:

```text
3K fisheye camera -> 1280x960 downsampled frame -> GPU nvAprilTagsDetect
```

Allowed directions:

- GPU-side or low-cost pre-processing before `nvAprilTagsDetect`.
- Contrast/brightness/gamma/CLAHE/equalization experiments that keep the GPU
  detector as the production detector.
- Exposure, gain, lighting, and tag placement improvements.
- Benchmarking each change against the original 1280x960 GPU pipeline.

Not allowed as default behavior:

- Python/OpenCV CPU AprilTag detector.
- Any default path that materially reduces frame rate just to make one image
  recognize successfully.

## Baseline To Preserve

The intended production camera path is:

```text
sensor: 3264x2464 full-FOV 3K fisheye
processing frame: 1280x960
detector: NVIDIA nvAprilTags GPU bench
launch: run_fullfov_1280x960_gui.sh
```

Before accepting future changes, record:

- Processing resolution.
- Effective frames per second.
- Tag detection rate.
- Whether the detector is still GPU `nvAprilTags`.
- Exact pre-processing inserted before the GPU detector.

## Stationary Dark-Scene Fix

The accepted fix for stationary dark-scene checks is a detector-input-only
preprocessing stage in the GPU bench:

```text
preprocess: gray_blur_gamma07
path: BGR frame -> grayscale -> 3x3 Gaussian blur -> gamma 0.70 -> BGRA upload -> nvAprilTagsDetect
display: original BGR frame with detection overlay
```

Verified on `192.168.1.80` at `1280x960`:

```text
frames=252
elapsed_s=12.02
fps=20.96
frames_with_tags=132
preprocess_ms avg=2.82
detect_ms avg=21.13
last tag id=3
```

This preserves the GPU detector and the 3K full-FOV downsampled runtime. It is
not a CPU AprilTag fallback.

The earlier continuity experiment kept the same detector path and added:

- duplicate-ID filtering in each frame, keeping the lower-hamming/larger-area tag
- optional bounded GUI last-good overlay
- optional bounded JSON last-good output with `is_held` and `held_ms`

Latest verification:

```text
frames=252
elapsed_s=12.03
fps=20.95
frames_with_tags=206
preprocess_ms avg=2.75
detect_ms avg=23.19
latest JSON id=3
```

This was useful for proving that the GPU path could recognize the tag, but it is
not acceptable for moving-arm sampling because stale positions visibly trail the
real tag.

## Moving-Arm Rule

For moving-arm operation, GUI and JSON hold are disabled, not merely shortened.
The current binary keeps `--gui-hold-ms` and `--output-hold-ms` as compatibility
arguments, but it writes and draws only current-frame detections.

If detection only works when motion stops, do not assume lighting is the only
cause. Benchmark the detector input distribution first: preprocessing,
resolution, ISP settings, and whether the tag still has enough pixels after
downsampling. Do not hide misses with stale tag positions.

The moving-arm launch path is:

```text
/home/nvidia/Desktop/yolo_fisheye_calibration_jetson/nv_gpu_apriltags_bench/run_motion_1280x960_gui.sh
```

Default moving-arm settings:

```text
preprocess: gray_blur_gamma07
path: BGR frame -> grayscale -> 3x3 Gaussian blur -> gamma 0.70 -> BGRA upload -> nvAprilTagsDetect
TNR: default ISP
exposuretimerange: default ISP
gainrange: default ISP
ispdigitalgainrange: default ISP
GUI/JSON hold: disabled
```

The current Jetson Xavier NX `nvarguscamerasrc` rejects
`exposuretimerange="13000 8000000"` even though the sensor mode log lists
13000 ns as the minimum. Use 34000 ns or higher for the lower bound.

## 2026-06-24 Motion-Mode Correction

The first motion-mode change used `motion` preprocessing, short exposure, and
TNR off. That was not supported by same-scene A/B results. On `192.168.1.80`:

```text
1280x960 gray_blur_gamma07, default ISP: 31 / 168 frames, 20.92 fps
1280x960 motion + 8 ms exposure + TNR off: 0 / 168 frames, 20.92 fps
1280x960 motion, default ISP: 0 / 168 frames, 20.94 fps
1280x960 gray_blur_gamma07 + 8 ms exposure + TNR off: 0 / 168 frames, 20.93 fps
960x724 gray_blur_gamma07, default ISP: 0 / 168 frames, 20.96 fps
1600x1208 gray_blur_gamma07, default ISP: 50 / 168 frames, 20.89 fps
```

Conclusion: keep GPU/no-hold, restore `gray_blur_gamma07` as the default input
preprocess, and use the higher-resolution `run_robust_1600x1208_gui.sh` path
when 1280x960 does not provide enough tag pixels. Do not make short exposure or
unsharp preprocessing the default without fresh A/B evidence.

The current robust GUI path runs:

```text
3264x2464@21 -> 1600x1208 -> gray_blur_gamma07 -> GPU nvAprilTagsDetect
GUI_SCALE=0.75
GUI_EVERY=2
```

`GUI_EVERY=2` reduces display overhead only. Detection and JSON output still run
on every processed detector frame. Last live check on `192.168.1.80` reported
about 19.2 fps, tag id 3, and `is_held=false`.
