NHK-DOT/delta_on_quadrotorUAV/Delta_Gcode_Servo/real_machine_test/jetson_py36/samples/20260626_151933/model_z_ge_155/fit_residuals.csv

label | timestamp | raw1 | raw2 | raw3 | vision_x_mm | vision_y_mm | vision_z_mm | fk_x_mm | fk_y_mm | fk_z_mm | predicted_vision_x_mm | predicted_vision_y_mm | predicted_vision_z_mm | residual_x_mm | residual_y_mm | residual_z_mm | residual_norm_mm
sample_0001 | 2026-06-26T15:22:32 | 678 | 703 | 703 | 396.88552258253634 | -533.6947808011666 | 303.1101254840092 | 2.8712799069259347 | -0.641142726324147 | 237.4329758399723 | 302.8712799069259 | -300.6411427263241 | 287.8376404649723 | -94.01424267561043 | 233.05363807484252 | -15.272485019036878 | 251.76561489696118
sample_0002 | 2026-06-26T15:22:41 | 698 | 723 | 722 | 395.923061637224 | -519.6366543061149 | 306.86556556416343 | 2.1914582598597394 | -0.36393767090091783 | 238.76724307001172 | 302.19145825985976 | -300.3639376709009 | 289.1719076950117 | -93.73160337736425 | 219.272716635214 | -17.693657869151707 | 239.12173314249162
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
