NHK-DOT/delta_on_quadrotorUAV/Delta_Gcode_Servo/real_machine_test/jetson_py36/samples/20260626_151933/samples.csv

index | label | timestamp_iso | raw1 | raw2 | raw3 | fk_x_mm | fk_y_mm | fk_z_mm | x_mm | y_mm | z_mm | offset_x_mm | offset_y_mm | offset_z_mm | vision_detection_id | vision_snapshot_age_ms | safe_scan_mode | battery_mv
1 | sample_0001 | 2026-06-26T15:22:32 | 678 | 703 | 703 | 5.7472581784872165 | -1.351831540461203 | 205.5524688231118 | 396.88552258253634 | -533.6947808011666 | 303.1101254840092 | 391.1382644040491 | -532.3429492607055 | 97.55765666089738 | 3 | 7.526397705078125 | FREE | 12264
2 | sample_0002 | 2026-06-26T15:22:41 | 698 | 723 | 722 | 5.906265984490608 | -1.0792040506527658 | 217.0073913579188 | 395.923061637224 | -519.6366543061149 | 306.86556556416343 | 390.0167956527334 | -518.5574502554622 | 89.85817420624463 | 3 | 40.117740631103516 | FREE | 12283
3 | sample_0003 | 2026-06-26T15:23:19 | 643 | 755 | 688 | 25.8968359548962 | 22.05575078352537 | 201.82719732214196 | 366.1566363504511 | -541.6073210325511 | 280.53617453061526 | 340.2598003955549 | -563.6630718160765 | 78.7089772084733 | 3 | 37.66465187072754 | FREE | 12303
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
