NHK-DOT/delta_on_quadrotorUAV/Delta_Gcode_Servo/real_machine_test/calibration_snapshots/20260708_135833_labeled_workspace_raw.csv

run_id | label | sample_in_label | timestamp_local | success | raw1 | raw2 | raw3 | error | tx_hex | command_byte
20260708_135833 | top_home | 1 | 2026-07-08T14:00:00 | True | 459 | 48 | 1021 |  | 55 55 06 15 03 01 02 03 | 0x15
20260708_135833 | top_home | 2 | 2026-07-08T14:00:01 | True | 458 | 48 | 1021 |  | 55 55 06 15 03 01 02 03 | 0x15
20260708_135833 | top_home | 3 | 2026-07-08T14:00:02 | True | 458 | 48 | 1021 |  | 55 55 06 15 03 01 02 03 | 0x15
20260708_135833 | top_home | 4 | 2026-07-08T14:00:03 | True | 459 | 48 | 1021 |  | 55 55 06 15 03 01 02 03 | 0x15
20260708_135833 | top_home | 5 | 2026-07-08T14:00:04 | True | 459 | 48 | 1021 |  | 55 55 06 15 03 01 02 03 | 0x15
20260708_135833 | bottom_safe | 1 | 2026-07-08T14:00:29 | True | -14 | 1121 | 656 |  | 55 55 06 15 03 01 02 03 | 0x15
20260708_135833 | bottom_safe | 2 | 2026-07-08T14:00:30 | True | -14 | 1121 | 623 |  | 55 55 06 15 03 01 02 03 | 0x15
20260708_135833 | bottom_safe | 3 | 2026-07-08T14:00:31 | True | -14 | 1120 | 622 |  | 55 55 06 15 03 01 02 03 | 0x15
20260708_135833 | bottom_safe | 4 | 2026-07-08T14:00:32 | True | -14 | 1120 | 622 |  | 55 55 06 15 03 01 02 03 | 0x15
20260708_135833 | bottom_safe | 5 | 2026-07-08T14:00:33 | True | -14 | 1120 | 622 |  | 55 55 06 15 03 01 02 03 | 0x15
20260708_135833 | center_mid | 1 | 2026-07-08T14:00:56 | True | 370 | -45 | 976 |  | 55 55 06 15 03 01 02 03 | 0x15
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
20260708_135833 | back_mid_redo | 6 | 2026-07-08T14:05:30 | True | 235 | -193 | 652 |  | 55 55 06 15 03 01 02 03 | 0x15
20260708_135833 | back_mid_redo | 7 | 2026-07-08T14:05:31 | True | 235 | -193 | 652 |  | 55 55 06 15 03 01 02 03 | 0x15
