NHK-DOT/delta_on_quadrotorUAV/Delta_Gcode_Servo/real_machine_test/calibration_snapshots/20260708_144450_readonly_apriltag_raw/samples.csv

run_id | index | label | timestamp_local | serial_success | raw1 | raw2 | raw3 | serial_error | tx_hex | command_byte | apriltag_success | apriltag_age_ms | apriltag_error | tag_seen | tag_id | tag_hamming | tag_center_x_px | tag_center_y_px | tag_x_m | tag_y_m | tag_z_m | preview_success | preview_error | tool_x_mm | tool_y_mm | tool_z_mm | ik_reachable | preview_raw1 | preview_raw2 | preview_raw3
20260708_144450_readonly_apriltag_raw | 1 | linkcheck_0001 | 2026-07-08T14:44:51 | True | 18 | 1167 | 673 |  | 55 55 06 15 03 01 02 03 | 0x15 | True | 446.3505744934082 |  | False |  |  |  |  |  |  |  | False | ValueError('snapshot contains no detections')
20260708_144450_readonly_apriltag_raw | 2 | linkcheck_0002 | 2026-07-08T14:44:53 | True | 18 | 1167 | 674 |  | 55 55 06 15 03 01 02 03 | 0x15 | True | 442.1045780181885 |  | False |  |  |  |  |  |  |  | False | ValueError('snapshot contains no detections')
20260708_144450_readonly_apriltag_raw | 3 | linkcheck_0003 | 2026-07-08T14:44:55 | True | 18 | 1167 | 673 |  | 55 55 06 15 03 01 02 03 | 0x15 | True | 433.6073398590088 |  | False |  |  |  |  |  |  |  | False | ValueError('snapshot contains no detections')
