NHK-DOT/delta_on_quadrotorUAV/Dual_Camera_HandEye/yolo_training/trained_models/wrench_current_manual_affine_gpu_e15/results.csv

epoch | time | train/box_loss | train/cls_loss | train/dfl_loss | metrics/precision(B) | metrics/recall(B) | metrics/mAP50(B) | metrics/mAP50-95(B) | val/box_loss | val/cls_loss | val/dfl_loss | lr/pg0 | lr/pg1 | lr/pg2
1 | 51.4966 | 0.92109 | 0.59993 | 1.37611 | 0.99892 | 1 | 0.995 | 0.84064 | 0.68953 | 0.44251 | 1.00876 | 0.000654321 | 0.000654321 | 0.000654321
2 | 93.7272 | 0.87053 | 0.53596 | 1.28333 | 0.99803 | 1 | 0.995 | 0.76133 | 0.92707 | 0.54948 | 1.23179 | 0.0013067 | 0.0013067 | 0.0013067
3 | 135.412 | 0.85182 | 0.52728 | 1.26538 | 0.99641 | 1 | 0.995 | 0.78661 | 0.83723 | 0.42305 | 1.11331 | 0.00190259 | 0.00190259 | 0.00190259
4 | 179.273 | 0.84503 | 0.53393 | 1.26546 | 0.99892 | 1 | 0.995 | 0.86021 | 0.53466 | 0.35862 | 0.91349 | 0.00181093 | 0.00181093 | 0.00181093
5 | 218.963 | 0.84332 | 0.52468 | 1.26312 | 0.99898 | 1 | 0.995 | 0.82902 | 0.6164 | 0.44435 | 0.91691 | 0.00167244 | 0.00167244 | 0.00167244
6 | 259.976 | 0.80958 | 0.49938 | 1.23356 | 0.9984 | 1 | 0.995 | 0.8612 | 0.66455 | 0.47991 | 0.92954 | 0.001505 | 0.001505 | 0.001505
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
