NHK-DOT/delta_on_quadrotorUAV/Dual_Camera_HandEye/yolo_training/trained_models/wrench_combined_gpu_resume_20260627/results.csv

epoch | time | train/box_loss | train/cls_loss | train/dfl_loss | metrics/precision(B) | metrics/recall(B) | metrics/mAP50(B) | metrics/mAP50-95(B) | val/box_loss | val/cls_loss | val/dfl_loss | lr/pg0 | lr/pg1 | lr/pg2
1 | 6.20294 | 0.66536 | 0.53386 | 1.083 | 0.99848 | 1 | 0.995 | 0.8971 | 0.46152 | 0.29561 | 0.80754 | 0.00018 | 0.00018 | 0.00018
2 | 10.6682 | 0.64823 | 0.46987 | 1.0838 | 0.99842 | 1 | 0.995 | 0.8763 | 0.65184 | 0.34519 | 0.95349 | 0.000379971 | 0.000379971 | 0.000379971
3 | 16.1291 | 0.68006 | 0.4652 | 1.08113 | 0.99838 | 1 | 0.995 | 0.93136 | 0.42114 | 0.25071 | 0.79856 | 0.000579825 | 0.000579825 | 0.000579825
4 | 19.8021 | 0.70798 | 0.47702 | 1.1148 | 0.99837 | 1 | 0.995 | 0.75817 | 0.98212 | 0.42787 | 1.17061 | 0.000779471 | 0.000779471 | 0.000779471
5 | 23.4445 | 0.72254 | 0.4904 | 1.10599 | 0.9936 | 1 | 0.995 | 0.79243 | 0.87089 | 0.42647 | 1.12402 | 0.000978818 | 0.000978818 | 0.000978818
6 | 26.6067 | 0.80415 | 0.53533 | 1.14812 | 0.99818 | 1 | 0.995 | 0.89215 | 0.56762 | 0.42347 | 0.95079 | 0.00117778 | 0.00117778 | 0.00117778
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
