NHK-DOT/delta_on_quadrotorUAV/Dual_Camera_HandEye/yolo_training/trained_models/wrench_combined_20260626/results.csv

epoch | time | train/box_loss | train/cls_loss | train/dfl_loss | metrics/precision(B) | metrics/recall(B) | metrics/mAP50(B) | metrics/mAP50-95(B) | val/box_loss | val/cls_loss | val/dfl_loss | lr/pg0 | lr/pg1 | lr/pg2
1 | 65.3643 | 1.47748 | 2.27821 | 1.7165 | 0.96655 | 1 | 0.99203 | 0.45899 | 1.40156 | 2.78558 | 1.6137 | 0.000649573 | 0.000649573 | 0.000649573
2 | 123.23 | 1.23096 | 1.51313 | 1.4537 | 0.89609 | 0.77778 | 0.9109 | 0.32375 | 1.90199 | 2.30116 | 2.30672 | 0.00131535 | 0.00131535 | 0.00131535
3 | 178.65 | 1.30145 | 1.49821 | 1.50815 | 0.95161 | 0.94444 | 0.9809 | 0.67564 | 1.14362 | 2.03946 | 1.45767 | 0.00197753 | 0.00197753 | 0.00197753
4 | 234.001 | 1.30964 | 1.42632 | 1.51431 | 0.88994 | 0.97222 | 0.96741 | 0.29857 | 2.31238 | 3.07847 | 2.50812 | 0.00198781 | 0.00198781 | 0.00198781
5 | 290.23 | 1.26916 | 1.31608 | 1.49161 | 0.51932 | 0.90044 | 0.76963 | 0.25615 | 1.97856 | 3.50894 | 2.54404 | 0.00197837 | 0.00197837 | 0.00197837
6 | 345.4 | 1.25283 | 1.24365 | 1.46718 | 0.99645 | 1 | 0.995 | 0.55454 | 1.50013 | 1.40493 | 1.65862 | 0.00196627 | 0.00196627 | 0.00196627
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
