NHK-DOT/delta_on_quadrotorUAV/Delta_Gcode_Servo/real_machine_test/jetson_py36/samples/20260626_151933/model_z_ge_155/rigid_alignment_residuals.csv

index | raw1 | raw2 | raw3 | fk_x_mm | fk_y_mm | fk_z_mm | vision_x_mm | vision_y_mm | vision_z_mm | pred_x_mm | pred_y_mm | pred_z_mm | residual_x_mm | residual_y_mm | residual_z_mm | residual_norm_mm
1 | 678 | 703 | 703 | 5.7472581784872165 | -1.351831540461203 | 205.5524688231118 | 396.88552258253634 | -533.6947808011666 | 303.1101254840092 | 387.3613306329944 | -523.0823536250643 | 302.1723497712817 | -9.524191949541944 | 10.612427176102301 | -0.9377757127275004 | 14.290320715336511
2 | 698 | 723 | 722 | 5.906265984490608 | -1.0792040506527658 | 217.0073913579188 | 395.923061637224 | -519.6366543061149 | 306.86556556416343 | 393.313028436031 | -531.2921497820965 | 307.51008335683144 | -2.610033201193005 | -11.655495475981638 | 0.6445177926680117 | 11.961532146302325
3 | 643 | 755 | 688 | 25.8968359548962 | 22.05575078352537 | 201.82719732214196 | 366.1566363504511 | -541.6073210325511 | 280.53617453061526 | 373.32815658236143 | -542.2716529916469 | 282.1064867581437 | 7.1715202319103355 | -0.6643319590957617 | 1.5703122275284613 | 7.371425905515206
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
