NHK-DOT/delta_on_quadrotorUAV/Delta_Gcode_Servo/real_machine_test/jetson_py36/samples/20260626_151933/model_z_ge_155/workspace_grid.csv

x_mm | y_mm | z_mm | xy_radius_mm | theta1_deg | theta2_deg | theta3_deg | raw1 | raw2 | raw3 | raw_limit_errors
-50.0 | -80.0 | 155.0 | 94.339811 | 115.021769 | 222.139817 | 118.00112 | 604 | 172 | 600
-45.0 | -80.0 | 155.0 | 91.787799 | 119.701279 | 222.60316 | 118.752463 | 584 | 168 | 596
-40.0 | -80.0 | 155.0 | 89.442719 | 124.306993 | 222.850398 | 119.262244 | 564 | 168 | 596
-35.0 | -80.0 | 155.0 | 87.321246 | 128.84583 | 222.871407 | 119.545479 | 548 | 168 | 592
-30.0 | -80.0 | 155.0 | 85.440037 | 133.320604 | 222.656209 | 119.614633 | 528 | 168 | 592
-25.0 | -80.0 | 155.0 | 83.815273 | 137.7305 | 222.195348 | 119.480244 | 508 | 168 | 592
-20.0 | -80.0 | 155.0 | 82.462113 | 142.071403 | 221.480262 | 119.151353 | 492 | 172 | 596
-15.0 | -80.0 | 155.0 | 81.394103 | 146.336164 | 220.50363 | 118.635796 | 472 | 176 | 596
-10.0 | -80.0 | 155.0 | 80.622577 | 150.514836 | 219.259657 | 117.940408 | 456 | 184 | 600
-5.0 | -80.0 | 155.0 | 80.156098 | 154.594942 | 217.744277 | 117.071148 | 440 | 188 | 604
0.0 | -80.0 | 155.0 | 80.0 | 158.561808 | 215.955239 | 116.033173 | 424 | 196 | 608
5.0 | -80.0 | 155.0 | 80.156098 | 162.398973 | 213.892074 | 114.830862 | 408 | 204 | 612
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
