NHK-DOT/delta_on_quadrotorUAV/Delta_Gcode_Servo/real_machine_test/apriltag_local_probe/th_adapt.png

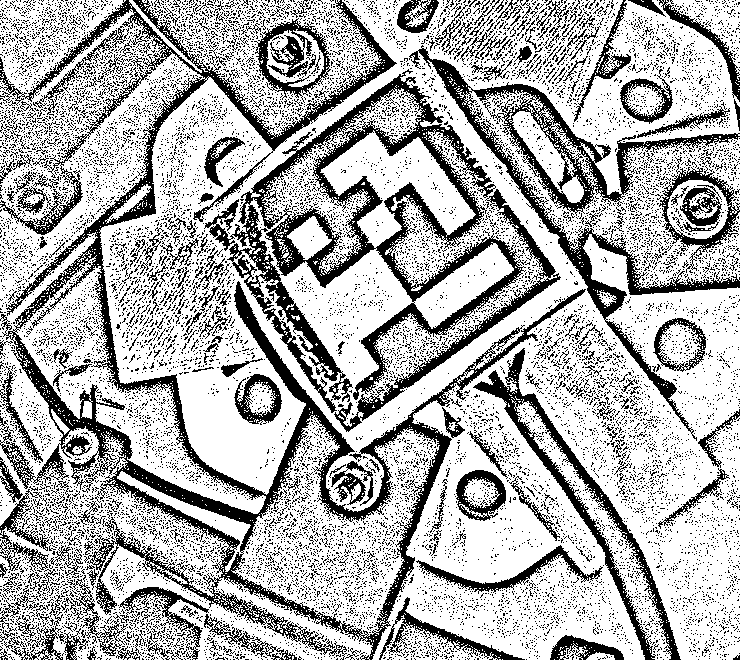
Delta_Gcode_Servo/real_machine_test/apriltag_local_probe/th_adapt.png
