NHK-DOT/delta_on_quadrotorUAV/Delta_Gcode_Servo/real_machine_test/fullfov_current_1280x960.jpg

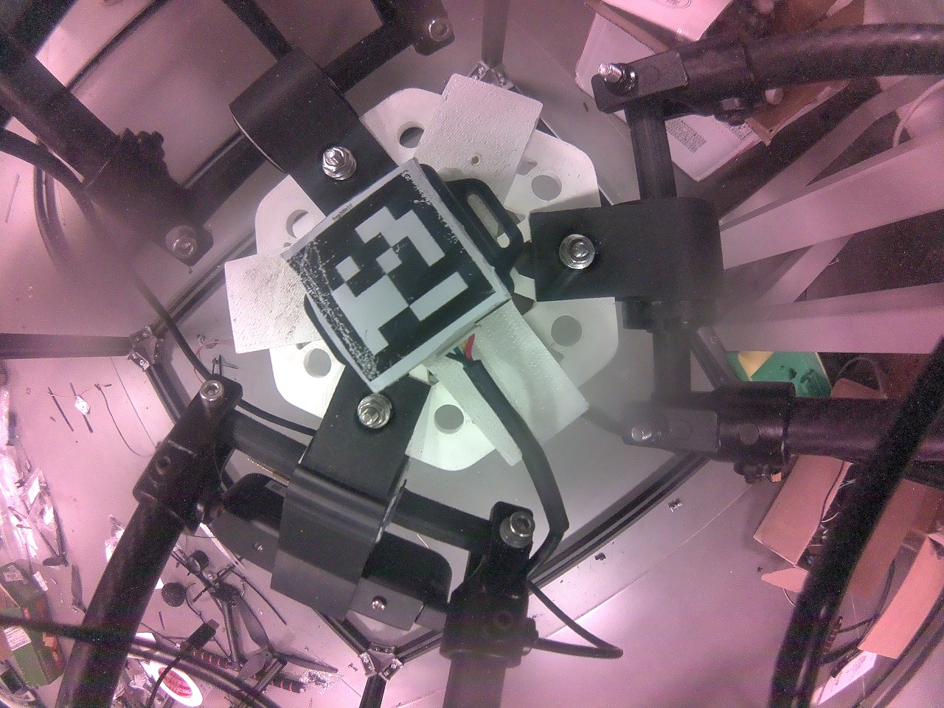
Delta_Gcode_Servo/real_machine_test/fullfov_current_1280x960.jpg
