NHK-DOT/delta_on_quadrotorUAV/Delta_Gcode_Servo/real_machine_test/jetson_fisheye_preview_screen2.png

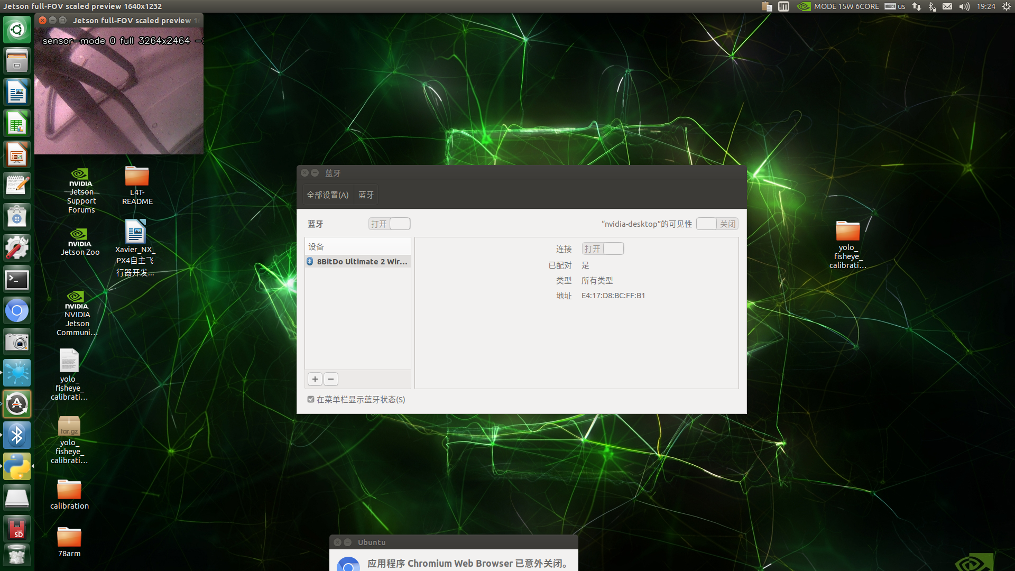
Delta_Gcode_Servo/real_machine_test/jetson_fisheye_preview_screen2.png
