NHK-DOT/delta_on_quadrotorUAV/Delta_Gcode_Servo/real_machine_test/live_cpu_probe_1600.jpg

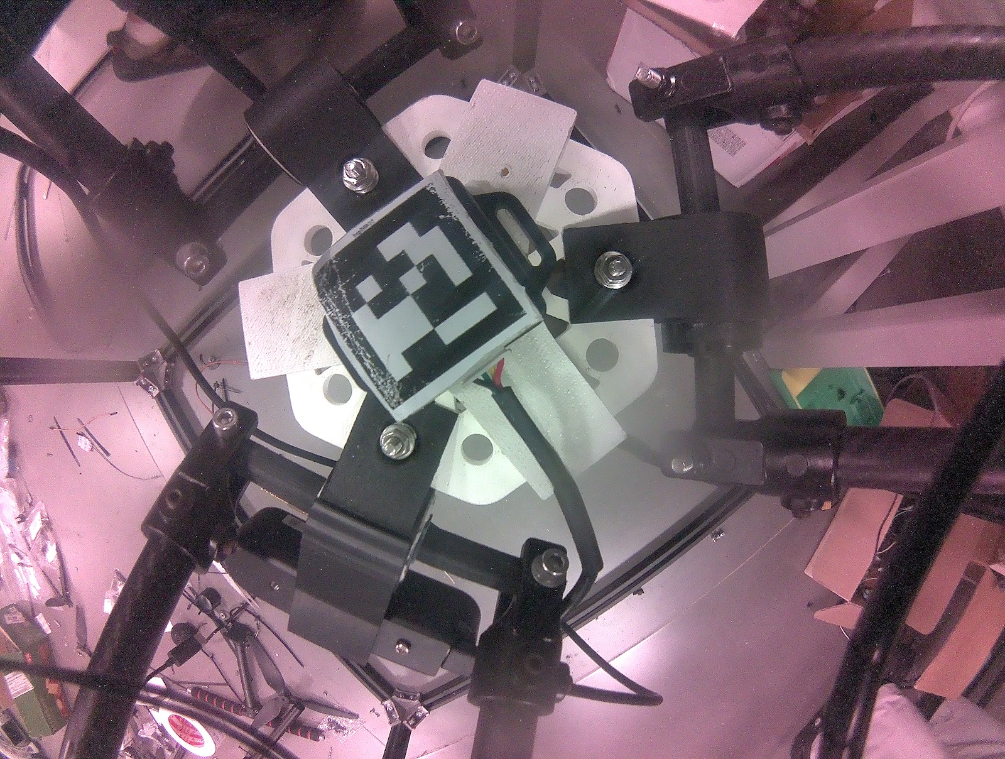
Delta_Gcode_Servo/real_machine_test/live_cpu_probe_1600.jpg
