NHK-DOT/delta_on_quadrotorUAV/Dual_Camera_HandEye/yolo_training/trained_models/wrench_combined_20260626/results.png

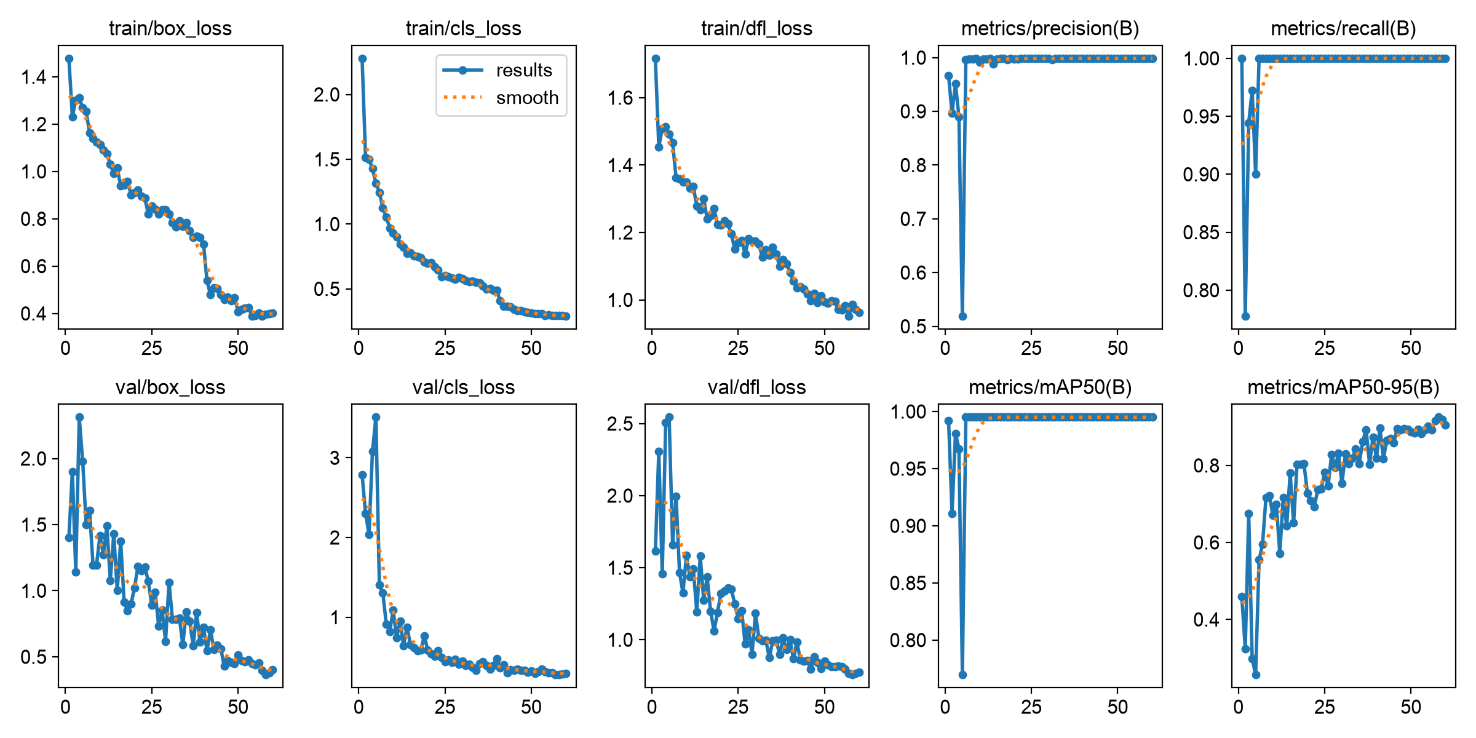
Dual_Camera_HandEye/yolo_training/trained_models/wrench_combined_20260626/results.png
