NHK-DOT/delta_on_quadrotorUAV/TexTest/system_preview.png

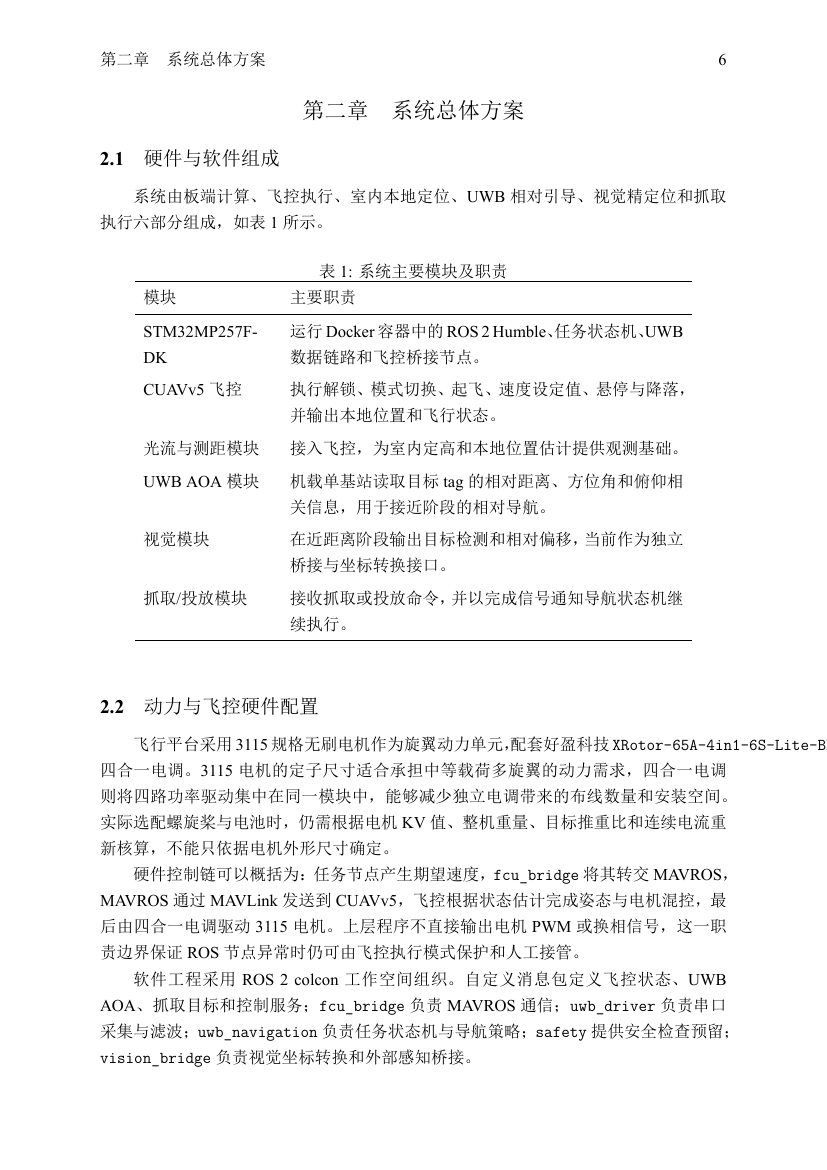
TexTest/system_preview.png
