NHK-DOT/delta_on_quadrotorUAV/tool_vision_web/raw_proxy_test.jpg

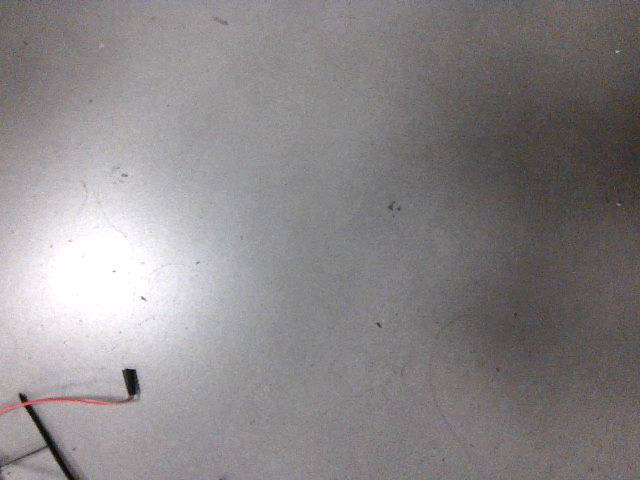
tool_vision_web/raw_proxy_test.jpg
