NHK-DOT/delta_on_quadrotorUAV/images/debug/徐州老味菜.jpg

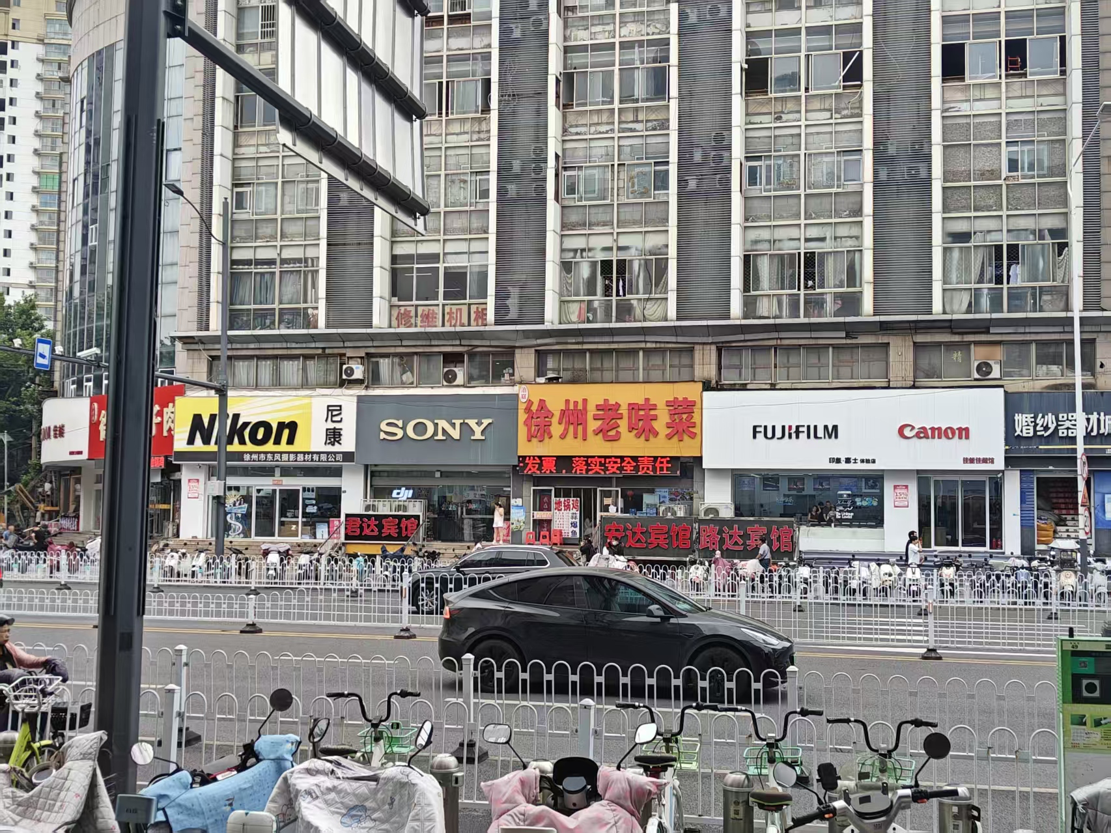
images/debug/徐州老味菜.jpg
