NHK-DOT/delta_on_quadrotorUAV/images/debug/本人热爱莫名其妙的图.jpg

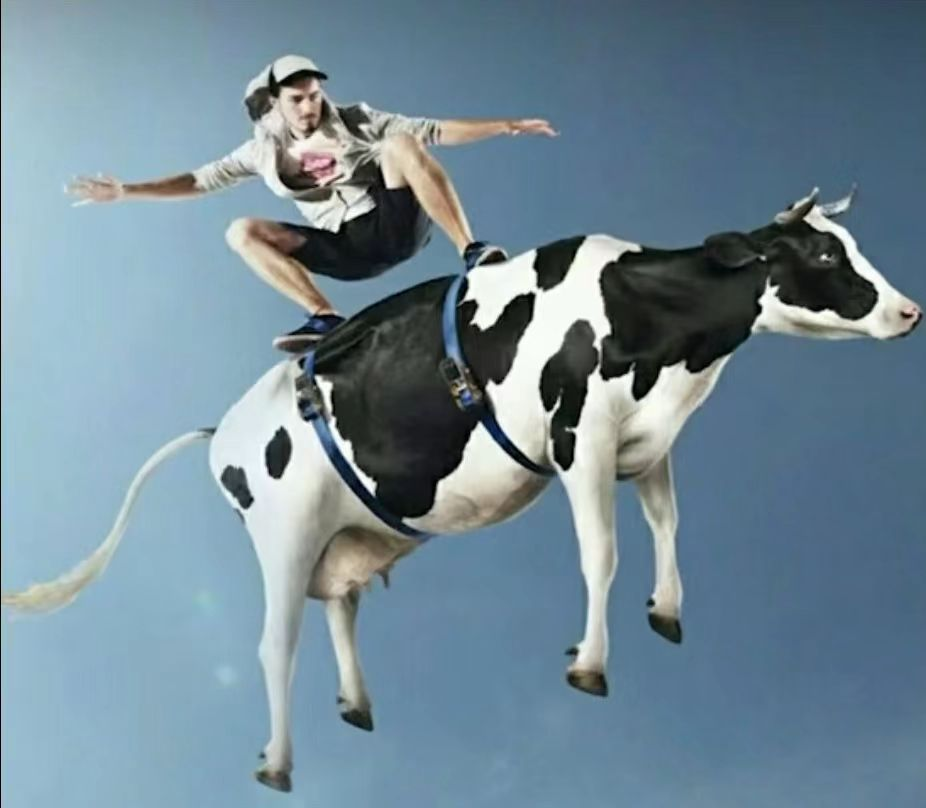
images/debug/本人热爱莫名其妙的图.jpg
