NHK-DOT/delta_on_quadrotorUAV/images/debug/比赛调试现场.jpg

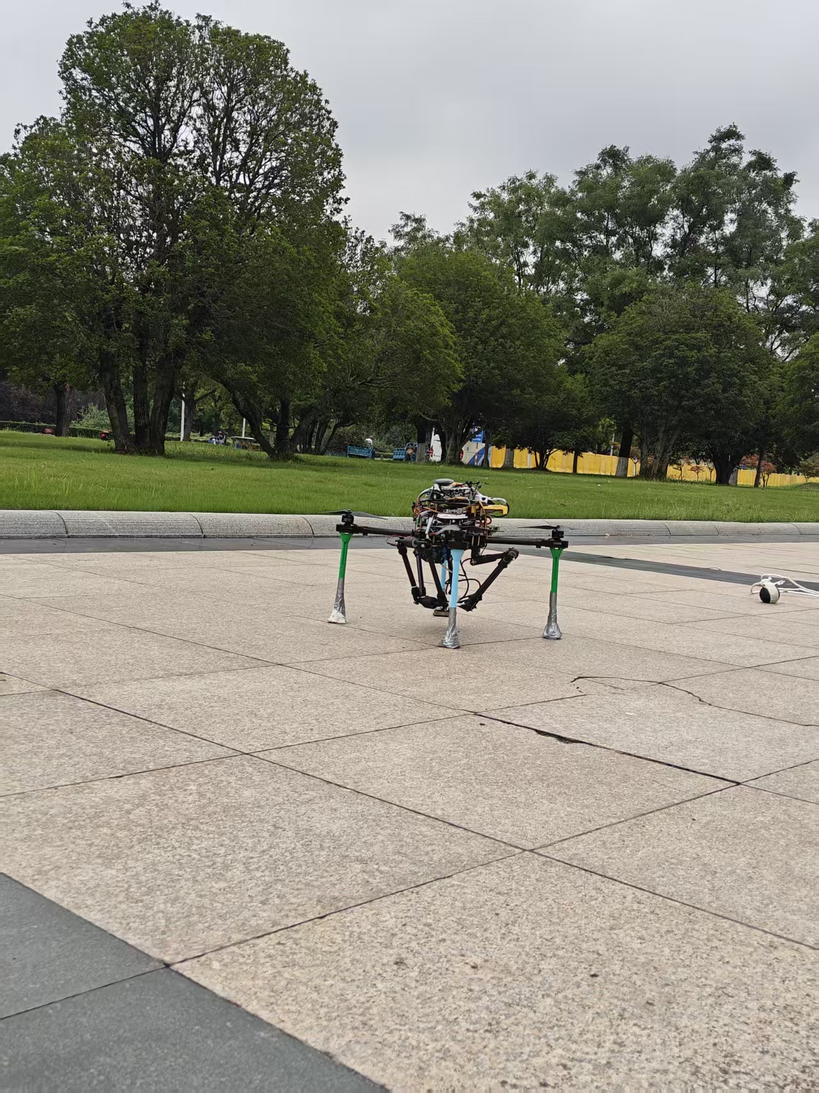
images/debug/比赛调试现场.jpg
