NHK-DOT/delta_on_quadrotorUAV/images/debug/飞行轨迹.png

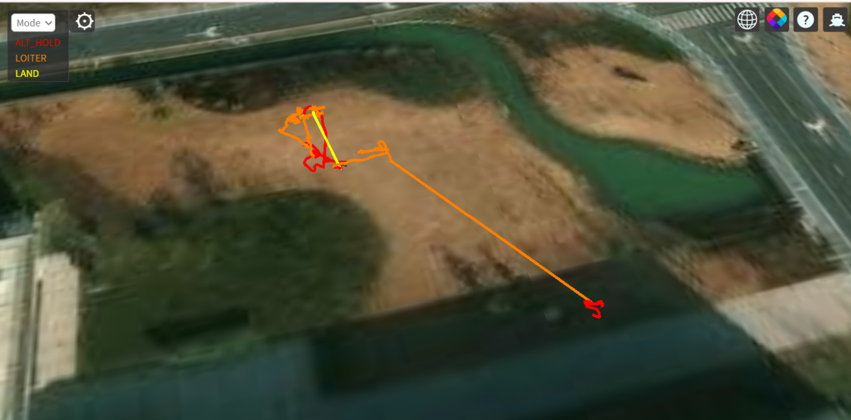
images/debug/飞行轨迹.png
