NHK-DOT/delta_on_quadrotorUAV/(list of files, drawings)

Other design files:
最新ALX-AOA-FIT跟随套件开发资料/单基站&双基站&四基站/信标硬件图/信标原理图.SCHLIB
最新ALX-AOA-FIT跟随套件开发资料/单基站&双基站&四基站/信标硬件图/信标封装.PcbLib
最新ALX-AOA-FIT跟随套件开发资料/单基站&双基站&四基站/信标硬件图/信标底板PCB.PcbDoc
最新ALX-AOA-FIT跟随套件开发资料/单基站&双基站&四基站/信标硬件图/信标底板原理图.SchDoc
最新ALX-AOA-FIT跟随套件开发资料/单基站&双基站&四基站/基站硬件图/基站封装.PcbLib
最新ALX-AOA-FIT跟随套件开发资料/单基站&双基站&四基站/基站硬件图/基站转接板原理图.PcbDoc
最新ALX-AOA-FIT跟随套件开发资料/单基站&双基站&四基站/基站硬件图/基站转接板原理图.SchDoc
最新ALX-AOA-FIT跟随套件开发资料/示例代码/演示跟随车核心资料/演示跟随车核心资料/Drive-motor V1.0.2/Drive-motor V1.0.2.PcbDoc
最新ALX-AOA-FIT跟随套件开发资料/示例代码/演示跟随车核心资料/演示跟随车核心资料/Drive-motor V1.0.2/Drive-motor V1.0.2.PrjPcb
最新ALX-AOA-FIT跟随套件开发资料/示例代码/演示跟随车核心资料/演示跟随车核心资料/Drive-motor V1.0.2/Drive-motor V1.0.2.SchDoc
