NHK-DOT/delta_on_quadrotorUAV/Delta_Gcode_Servo/delta_gcode_servo/config.py

from __future__ import annotations

from dataclasses import dataclass, field
from math import pi, radians
from typing import Dict, List


@dataclass
class RobotParams:
    l1: float = 100.0
    l2: float = 150.0
    l3: float = 48.0
    servo_offset_x: float = 75.0
    servo_offset_y: float = 0.0
    servo_offset_z: float = 41.231
    servo_offset_z_inverted: float = -293.0
    servo_angle_min: float = field(default_factory=lambda: radians(45.0))
    servo_angle_max: float = field(default_factory=lambda: radians(225.0))
    workspace_z_min: float = 90.0
    workspace_z_max: float = 280.0
    workspace_xy_max: float = 150.0
    ball_joint_angle_limit: float = field(default_factory=lambda: radians(34.1))
    num_servos: int = 3
    servo_distribution: List[float] = field(default_factory=lambda: [-pi / 2, pi / 6, 5 * pi / 6])
    step_increment_linear: float = 1.8
    step_delay_linear: float = 0.0
    home_position: List[float] = field(default_factory=lambda: [0.0, 0.0, 240.0])
    ik_tolerance: float = 1e-6
    collision_margin: float = 5.0
    # Current hardware split on the 6-servo bus:
    # 1/3/4 are the real delta-arm actuators used by IK/FK.
    # 2 is not used by the current arm wiring; 5/6 are optional auxiliary servos.
    servo_ids: List[int] = field(default_factory=lambda: [1, 3, 4])
    landing_gear_servo_ids: List[int] = field(default_factory=lambda: [5, 6])
    landing_gear_down_raw: int = 500
    landing_gear_up_raw: int = 1000
    landing_gear_move_time_ms: int = 180
    servo_physical_angle_min_deg: float = 0.0
    servo_physical_angle_max_deg: float = 240.0
    servo_position_min: int = 0
    servo_position_max: int = 1000
    servo_position_step: int = 1

    @property
    def end_effector_types(self) -> Dict[str, int]:
        return {
            "NONE": 0,
            "CONTINUOUS_ROTATION": 1,
            "CLAW_GRIPPER": 2,
            "VACUUM_GRIPPER": 3,
            "ELECTROMAGNET": 4,
        }


def robot_params() -> RobotParams:
    return RobotParams()
