NHK-DOT/delta_on_quadrotorUAV/最新ALX-AOA-FIT跟随套件开发资料/示例代码/STM32F1-Usart/STM32F1-Usart/User/APP/main.h

/*
 *******************************************************************************
 *                           Includes
 *******************************************************************************
 */
#ifndef _USER_MAIN_H
#define _USER_MAIN_H

/* Includes */
#include <stdio.h>
#include <stddef.h>
#include <stdint.h>
#include <stdlib.h>
#include <string.h>
#include <math.h>
#include <time.h>
#include <assert.h>
/* Includes */
#include "stm32f10x.h"
#include "delay.h"
#include "dataoperation.h"
#include "port.h"
#include "uart.h"
#include "uart1.h"
#include "usart1process.h"

#endif  //_USER_MAIN_H
