NHK-DOT/delta_on_quadrotorUAV/最新ALX-AOA-FIT跟随套件开发资料/示例代码/STM32F1-Usart/STM32F1-Usart/User/Drivers/uart.h

/*
 *******************************************************************************
 *
 *******************************************************************************
 */
#ifndef _USER_UART_H
#define _USER_UART_H




#define UART_IDLE	0
#define UART_BUSY	1
#define UART_RECVING	2
#define UART_RECED	3
#define UART_SENDING	4
#define UART_SENDED	5



#endif	//_USER_UART_H
