NHK-DOT/delta_on_quadrotorUAV/Uav_Delta_capture/uav_delta_capture/src/uwb_navigation/config/test_mission_bench.yaml

test_mission_node:
  ros__parameters:
    # Topics
    uwb_aoa_topic: uwb_aoa/data
    fcu_state_topic: fcu_state
    local_pose_topic: /mavros/local_position/pose
    fcu_link_topic: fcu_link/status
    cmd_vel_topic: cmd_vel
    mission_state_topic: test_mission/state
    mission_event_topic: test_mission/event
    flight_command_service: flight_command

    # Mode: real hardware bench preflight with a short vertical velocity profile.
    mission_mode: bench_velocity
    use_mock: false
    desktop_test: true
    arm_mode: ALT_HOLD

    # Bench velocity smoke test. No propellers.
    bench_velocity_z: 0.20
    bench_climb_sec: 4.0
    bench_hold_sec: 3.0
    bench_descend_sec: 4.0
    bench_zero_sec: 2.0
    bench_sensor_timeout: 2.0
    bench_exit_on_complete: true

    # Bench mode records UWB/local-pose readiness but does not block on them.
    # This mode is for no-propeller ARM + velocity-setpoint link testing.
    require_uwb_ready: false
    require_local_pose_ready: false
    uwb_signal_timeout: 3.0
    local_pose_timeout: 1.0

    # Shared control limits
    takeoff_altitude: 1.5
    descend_altitude: 0.5
    kp_horizontal: 0.4
    kp_vertical: 0.3
    kp_return: 0.5
    max_vel_xy: 0.5
    max_vel_z: 0.3
    velocity_slew_rate: 0.4
    azimuth_deadband: 3.0
    horizontal_deadband: 0.15
    altitude_tolerance: 0.15
    return_xy_tolerance: 0.3
    hover_stable_time: 2.0
    control_rate_hz: 20.0
    low_battery_pct: 20.0
    recovery_timeout: 3.0
    set_mode_service_timeout_sec: 8.0
    mode_confirm_timeout_sec: 8.0
    auto_modes: GUIDED

    # Placeholders, unused by bench mode.
    fake_grasp: true
    fake_grasp_delay_sec: 10.0
    grasp_timeout_sec: 15.0
    fake_drop: true
    fake_drop_delay_sec: 2.0
    drop_timeout_sec: 10.0
    grasp_done_topic: grasp_done
    drop_done_topic: drop_done
