NHK-DOT/delta_on_quadrotorUAV/(commit log)

2026-04-28 gui added
    [delta_path_20260408_110506_servo.json, delta_path_test.servo.json, workspace_points.csv]
2026-05-12 smallest arm control package on UAV
2026-05-28 Add arm photos to root readmes
2026-05-29 Add GPLv3 license and revised arm models
    [666.SLDPRT, 6666.3mf, 保存实体1[2].SLDPRT, 圆角13.SLDPRT, 肱二头肌.SLDPRT, 零件2.SLDPRT]
2026-06-09 Add dual camera hand-eye calibration demo
2026-06-10 Update dual camera hand-eye workflow
    [999.STL]
2026-06-11 Add Jetson vision export package
2026-06-11 Update README for Jetson vision export
2026-06-18 Add base camera tool pose preview
2026-06-20 Add full-start structure calibration sampler
2026-06-20 Add YOLO fisheye camera calibration
2026-06-20 Package Jetson YOLO fisheye calibration
2026-06-22 Update Jetson fisheye calibration workflow
2026-06-23 Add Jetson full-FOV GPU AprilTag pipeline
2026-06-23 Prune legacy 8BitDo package for Jetson sampler
2026-06-23 Revert "Add equalized OpenCV AprilTag producer"
    This reverts commit a7ba218eda73bec3809558aad55fbb0d129b91f9.
    [jetson_workspace_common.py]
2026-06-24 Document workspace calibration flow
2026-06-25 Harden workspace sampler startup checks
2026-06-25 Update LX225 mappings and Jetson workspace docs
2026-06-26 Add Jetson workspace calibration run
    [fit_residuals.csv, rigid_alignment_residuals.csv, samples.csv, samples_z_ge_155.csv, workspace_grid.csv]
2026-06-26 Add Orbbec depth camera probe
2026-06-26 Add fused wrench depth startup
2026-06-26 Add fused wrench pose publisher
2026-06-26 Add Jetson wrench image follower
2026-06-26 Smooth wrench image follower error
    [jetson_wrench_image_follower_py36.py]
2026-06-26 Add trained combined wrench detector
    [results.csv]
2026-06-26 Switch wrench service default to trained engine
2026-06-27 Update wrench Jetson runtime handoff
2026-06-27 Fix smoothed wrench follow preview
    [wrench_image_follow_preview.py]
2026-06-27 Record wrench arm bench follow check
2026-06-27 Add CUDA-resumed wrench detector artifacts
    [results.csv]
2026-06-28 Add current manual affine wrench detector artifacts
    [results.csv]
2026-06-28 Use servo feedback FK for wrench coordinate fusion
2026-06-28 Add rough motion-fit hand-eye calibration
2026-06-28 Tighten servo feedback lead limits
    [jetson_apriltag_workspace_sampler_py36.py, jetson_wrench_image_follower_py36.py, servo_feedback_follow_check_py36.py]
2026-06-28 Document axis 3 servo follow blocker
2026-06-28 Add servo hold refresh mitigation
2026-06-28 Add bounded servo feedback nudge diagnostic
2026-06-28 Add optional servo feedback hold mode
2026-07-08 Add Jetson wrench grasp demo
2026-07-13 Integrate NX and STM32MP257 UAV interface
2026-07-14 Add desktop CAD drawings and refresh system images
    [1.SLDASM, 1.SLDPRT, 2.stl, 2222.STEP, 2222.STL, 333.STL, 66.3mf, 666.STEP]
2026-07-14 Document NX MP257 wired ROS2 link
2026-07-21 Finalize 78arm UAV hardware and control update
    [1.SLDASM, 1.SLDPRT, 20260708_120837_manual_workspace_raw_stream.csv, 20260708_135833_labeled_workspace_raw.csv, 3舵机大座.stl, 66.3mf, 6个塑料轴承套筒.3mf, 78.SLDPRT]
